ghgemmer/Halloween/TerminalLabels.docx

Arm Pitch 6V | Arm Pitch Gnd | Arm Pitch Ctrl | Arm Roll 6V | Arm Roll Gnd | Arm Roll Ctrl

Arm Yaw 6V | Arm Yaw Gnd | Arm Yaw Ctrl | Elbow Pitch 6V | Elbow Pitch Gnd | Elbow Pitch Ctrl

Mouth Ctrl | Mouth 6V | Mouth Gnd | 5V | Gnd
