ghgemmer/Halloween/IHome speaker used in vampire prop uses regular USB 2.docx

IHome speaker used in vampire prop uses regular USB 2.0 connection for charging (from computer or whatever). Manal for IHome speaker is in the “Furniture” folder
