ghgemmer/Halloween/AU5120.pdf

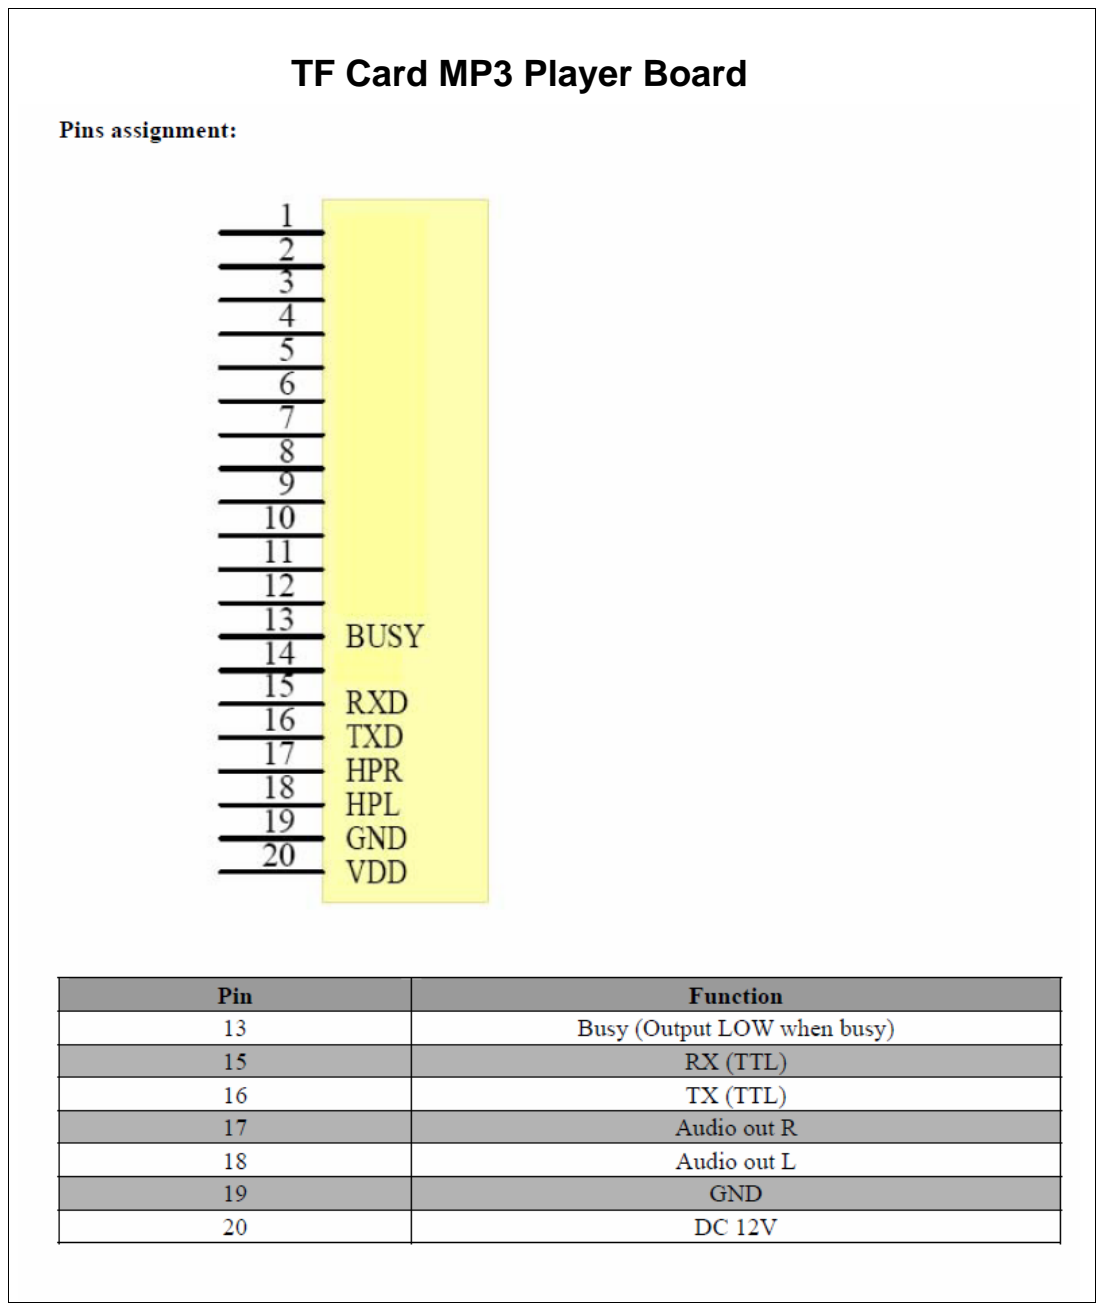
[picture p23: page 1]

TF Card MP3 Player Board

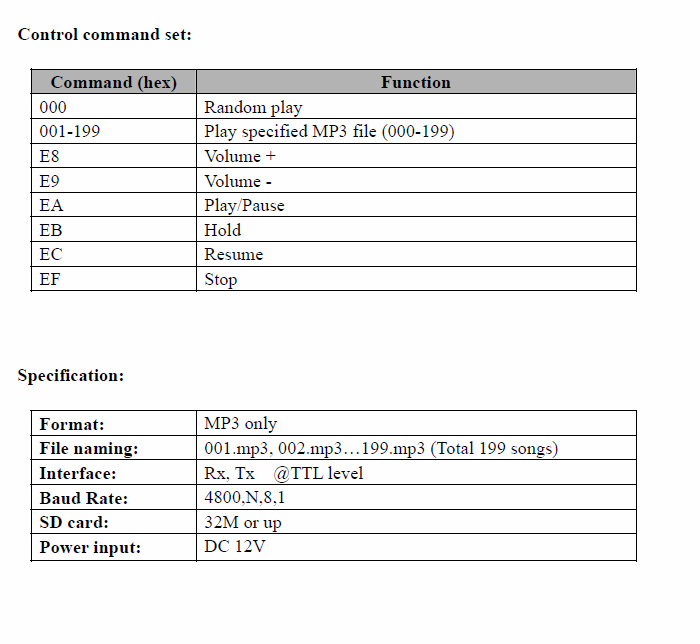
[picture p24: figure]

www.mdfly.com
