ghgemmer/Halloween/AlbumArt_{B5020207-474E-4720-407C-4E2F51993500}_Large.jpg

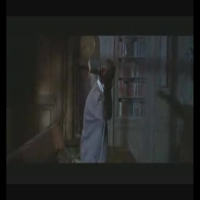
AlbumArt_{B5020207-474E-4720-407C-4E2F51993500}_Large.jpg
