ghgemmer/Halloween/Folder.jpg

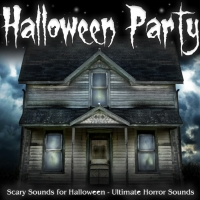
Folder.jpg
