ghgemmer/Halloween/PropPics/20211105_211012.jpg

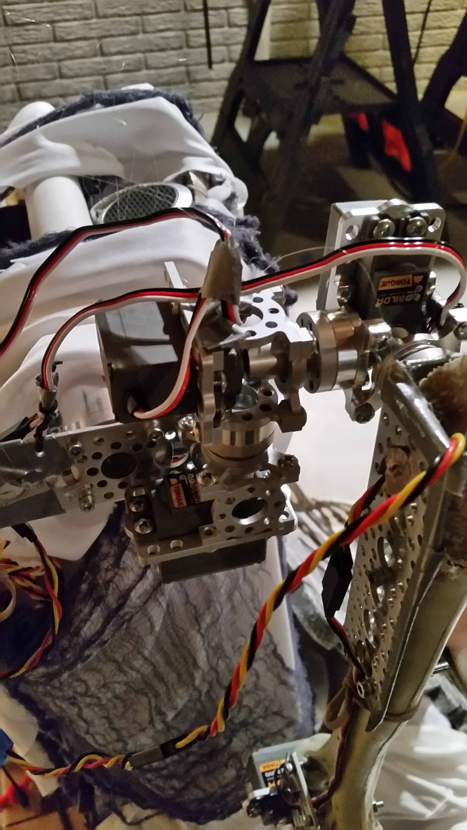
PropPics/20211105_211012.jpg
