ghgemmer/Halloween/PropPics/20211105_211126.jpg

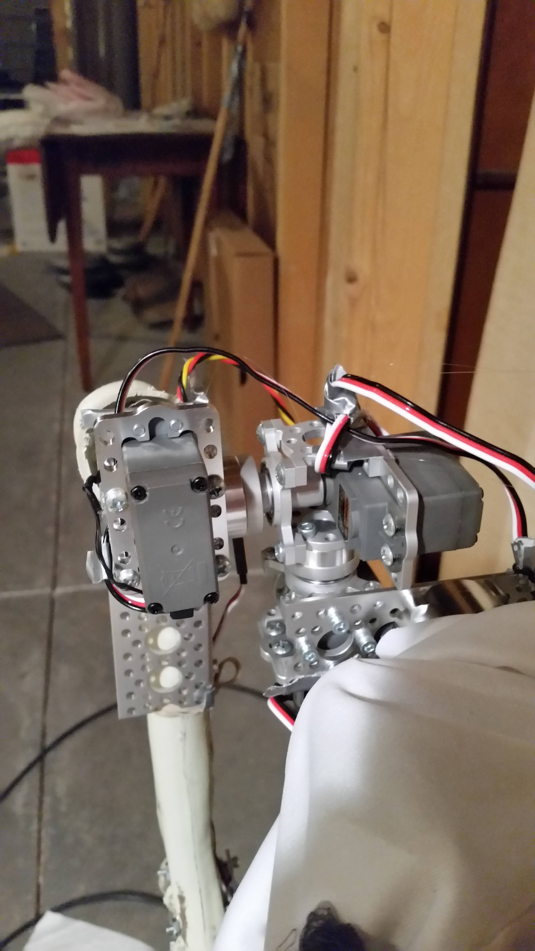
PropPics/20211105_211126.jpg
