ghgemmer/Halloween/PropPics/20211109_203104.jpg

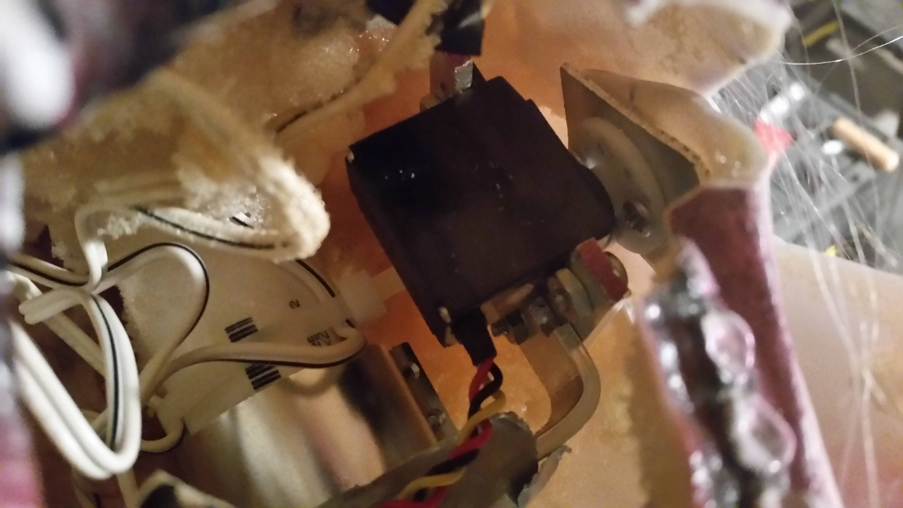
PropPics/20211109_203104.jpg
