ghgemmer/Halloween/PropPics/20211110_141706.jpg

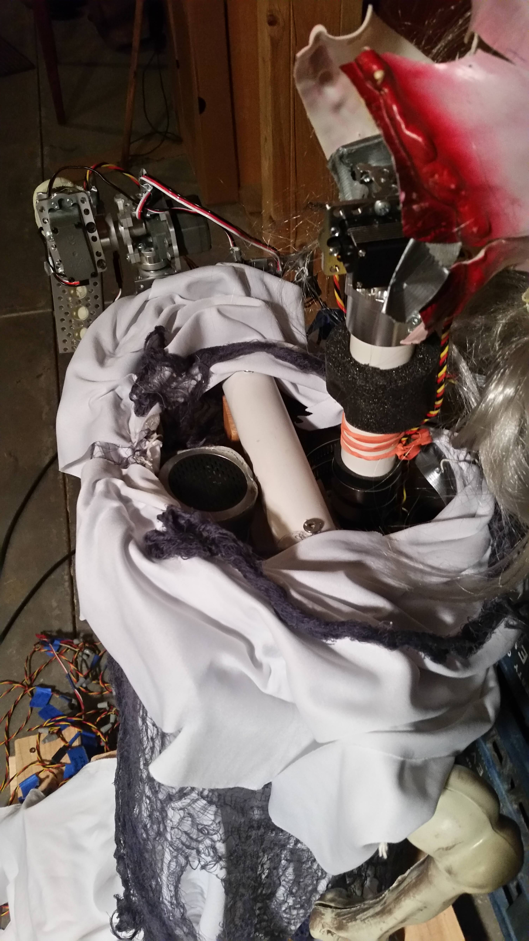
PropPics/20211110_141706.jpg
