ghgemmer/Halloween/PropPics/20240823_203854.jpg

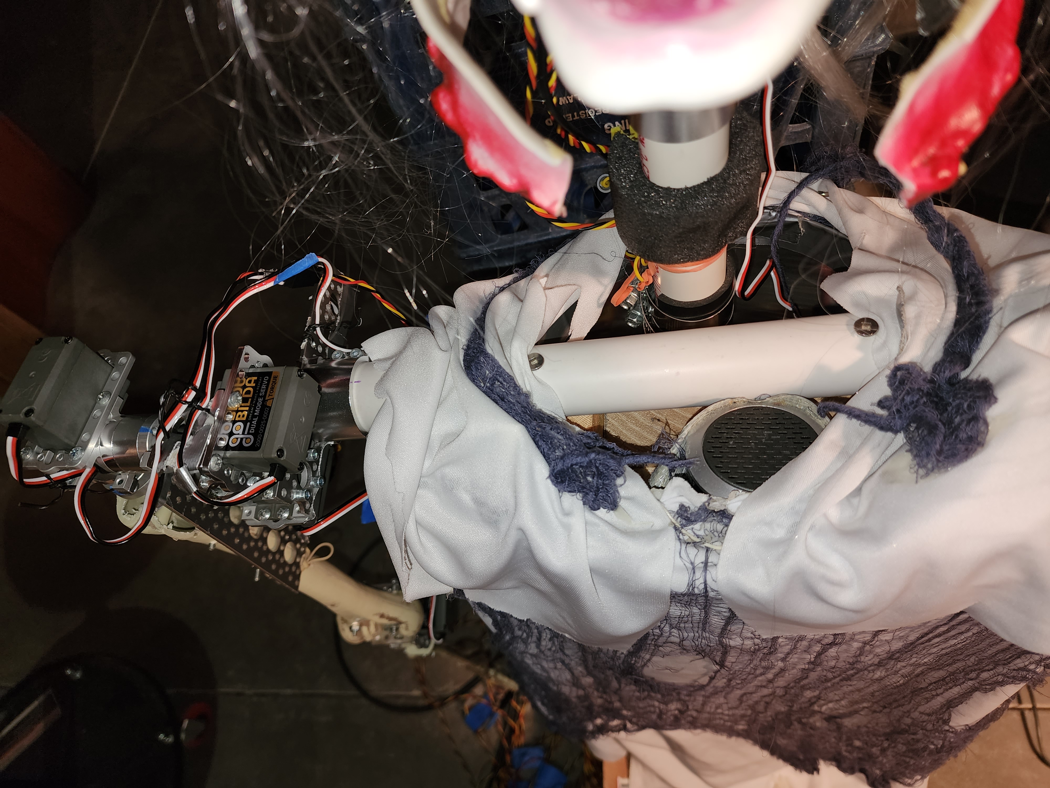
PropPics/20240823_203854.jpg
