ghgemmer/Halloween/PWMServo/SavedImplementations/Impl2/TestServos/DebugLog1.txt

(this log was before also logged servoIndex in PWMServoNew::write)

Enter PWMServoNew::attachint pinArg: 0 min: 800 max: 2200
attach Before - Reg Contents
Timer:1
TCCR1A:Adrs: 80 Val:1

TCCR1B:Adrs: 81 Val:3

OCR1A:Adrs: 88 Val:0

OCR1B:Adrs: 8A Val:0

OCR1C:Adrs: 8C Val:0

TIMSK1:Adrs: 6F Val:0

ICR1:Adrs: 86 Val:0

Timer:3
TCCR3A:Adrs: 90 Val:1

TCCR3B:Adrs: 91 Val:3

OCR3A:Adrs: 98 Val:0

OCR3B:Adrs: 9A Val:0

OCR3C:Adrs: 9C Val:0

TIMSK3:Adrs: 71 Val:0

ICR3:Adrs: 96 Val:0

Timer:4
TCCR4A:Adrs: A0 Val:1

TCCR4B:Adrs: A1 Val:3

OCR4A:Adrs: A8 Val:0

OCR4B:Adrs: AA Val:0

OCR4C:Adrs: AC Val:0

TIMSK4:Adrs: 72 Val:0

ICR4:Adrs: A6 Val:0

Timer:5
TCCR5A:Adrs: 120 Val:1

TCCR5B:Adrs: 121 Val:3

OCR5A:Adrs: 128 Val:0

OCR5B:Adrs: 12A Val:0

OCR5C:Adrs: 12C Val:0

TIMSK5:Adrs: 73 Val:0

ICR5:Adrs: 126 Val:0

HdwrCntrlInfo:
sizeof volatile unit16_t * :2
servoPinIndex: 0
boardPinNumber: 11
tccrnA: 80
tccrnB: 81
ocrnA: 88
ocrnB: 8A
timskn: 6F
icrn: 86
attachTccrnaClrMsk: 40
attachTccrnaSetMsk: 80
seizeTimerTimsknClrMsk: F
seizeTimerTimsknSetMsk: 0
detachTccrnaClrMsk: C0
detachTccrnaSetMsk: 0
writeOcrnx: 88
Enter PWMServoNew::seizeTimer
Reg Contents Before
Timer:1
TCCR1A:Adrs: 80 Val:1

TCCR1B:Adrs: 81 Val:3

OCR1A:Adrs: 88 Val:0

OCR1B:Adrs: 8A Val:0

OCR1C:Adrs: 8C Val:0

TIMSK1:Adrs: 6F Val:0

ICR1:Adrs: 86 Val:0

Timer:3
TCCR3A:Adrs: 90 Val:1

TCCR3B:Adrs: 91 Val:3

OCR3A:Adrs: 98 Val:0

OCR3B:Adrs: 9A Val:0

OCR3C:Adrs: 9C Val:0

TIMSK3:Adrs: 71 Val:0

ICR3:Adrs: 96 Val:0

Timer:4
TCCR4A:Adrs: A0 Val:1

TCCR4B:Adrs: A1 Val:3

OCR4A:Adrs: A8 Val:0

OCR4B:Adrs: AA Val:0

OCR4C:Adrs: AC Val:0

TIMSK4:Adrs: 72 Val:0

ICR4:Adrs: A6 Val:0

Timer:5
TCCR5A:Adrs: 120 Val:1

TCCR5B:Adrs: 121 Val:3

OCR5A:Adrs: 128 Val:0

OCR5B:Adrs: 12A Val:0

OCR5C:Adrs: 12C Val:0

TIMSK5:Adrs: 73 Val:0

ICR5:Adrs: 126 Val:0

Reg Contents After
Timer:1
TCCR1A:Adrs: 80 Val:2

TCCR1B:Adrs: 81 Val:1A

OCR1A:Adrs: 88 Val:BB8

OCR1B:Adrs: 8A Val:BB8

OCR1C:Adrs: 8C Val:0

TIMSK1:Adrs: 6F Val:0

ICR1:Adrs: 86 Val:9C40

Timer:3
TCCR3A:Adrs: 90 Val:1

TCCR3B:Adrs: 91 Val:3

OCR3A:Adrs: 98 Val:0

OCR3B:Adrs: 9A Val:0

OCR3C:Adrs: 9C Val:0

TIMSK3:Adrs: 71 Val:0

ICR3:Adrs: 96 Val:0

Timer:4
TCCR4A:Adrs: A0 Val:1

TCCR4B:Adrs: A1 Val:3

OCR4A:Adrs: A8 Val:0

OCR4B:Adrs: AA Val:0

OCR4C:Adrs: AC Val:0

TIMSK4:Adrs: 72 Val:0

ICR4:Adrs: A6 Val:0

Timer:5
TCCR5A:Adrs: 120 Val:1

TCCR5B:Adrs: 121 Val:3

OCR5A:Adrs: 128 Val:0

OCR5B:Adrs: 12A Val:0

OCR5C:Adrs: 12C Val:0

TIMSK5:Adrs: 73 Val:0

ICR5:Adrs: 126 Val:0

Exit PWMServoNew::seizeTimer
attach After - Reg Contents
Timer:1
TCCR1A:Adrs: 80 Val:82

TCCR1B:Adrs: 81 Val:1A

OCR1A:Adrs: 88 Val:BB8

OCR1B:Adrs: 8A Val:BB8

OCR1C:Adrs: 8C Val:0

TIMSK1:Adrs: 6F Val:0

ICR1:Adrs: 86 Val:9C40

Timer:3
TCCR3A:Adrs: 90 Val:1

TCCR3B:Adrs: 91 Val:3

OCR3A:Adrs: 98 Val:0

OCR3B:Adrs: 9A Val:0

OCR3C:Adrs: 9C Val:0

TIMSK3:Adrs: 71 Val:0

ICR3:Adrs: 96 Val:0

Timer:4
TCCR4A:Adrs: A0 Val:1

TCCR4B:Adrs: A1 Val:3

OCR4A:Adrs: A8 Val:0

OCR4B:Adrs: AA Val:0

OCR4C:Adrs: AC Val:0

TIMSK4:Adrs: 72 Val:0

ICR4:Adrs: A6 Val:0

Timer:5
TCCR5A:Adrs: 120 Val:1

TCCR5B:Adrs: 121 Val:3

OCR5A:Adrs: 128 Val:0

OCR5B:Adrs: 12A Val:0

OCR5C:Adrs: 12C Val:0

TIMSK5:Adrs: 73 Val:0

ICR5:Adrs: 126 Val:0

Servo Index:0 Attached:1
Servo Index:1 Attached:0
Servo Index:2 Attached:0
Servo Index:3 Attached:0
Servo Index:4 Attached:0
Servo Index:5 Attached:0
Servo Index:6 Attached:0
Servo Index:7 Attached:0
Servo Index:8 Attached:0
Servo Index:9 Attached:0
Servo Index:10 Attached:0
Servo Index:11 Attached:0
Exit PWMServoNew::attach
Enter PWMServoNew::attachint pinArg: 1 min: 800 max: 2200
attach Before - Reg Contents
Timer:1
TCCR1A:Adrs: 80 Val:82

TCCR1B:Adrs: 81 Val:1A

OCR1A:Adrs: 88 Val:BB8

OCR1B:Adrs: 8A Val:BB8

OCR1C:Adrs: 8C Val:0

TIMSK1:Adrs: 6F Val:0

ICR1:Adrs: 86 Val:9C40

Timer:3
TCCR3A:Adrs: 90 Val:1

TCCR3B:Adrs: 91 Val:3

OCR3A:Adrs: 98 Val:0

OCR3B:Adrs: 9A Val:0

OCR3C:Adrs: 9C Val:0

TIMSK3:Adrs: 71 Val:0

ICR3:Adrs: 96 Val:0

Timer:4
TCCR4A:Adrs: A0 Val:1

TCCR4B:Adrs: A1 Val:3

OCR4A:Adrs: A8 Val:0

OCR4B:Adrs: AA Val:0

OCR4C:Adrs: AC Val:0

TIMSK4:Adrs: 72 Val:0

ICR4:Adrs: A6 Val:0

Timer:5
TCCR5A:Adrs: 120 Val:1

TCCR5B:Adrs: 121 Val:3

OCR5A:Adrs: 128 Val:0

OCR5B:Adrs: 12A Val:0

OCR5C:Adrs: 12C Val:0

TIMSK5:Adrs: 73 Val:0

ICR5:Adrs: 126 Val:0

HdwrCntrlInfo:
sizeof volatile unit16_t * :2
servoPinIndex: 1
boardPinNumber: 12
tccrnA: 80
tccrnB: 81
ocrnA: 88
ocrnB: 8A
timskn: 6F
icrn: 86
attachTccrnaClrMsk: 10
attachTccrnaSetMsk: 20
seizeTimerTimsknClrMsk: F
seizeTimerTimsknSetMsk: 0
detachTccrnaClrMsk: 30
detachTccrnaSetMsk: 0
writeOcrnx: 8A
attach After - Reg Contents
Timer:1
TCCR1A:Adrs: 80 Val:A2

TCCR1B:Adrs: 81 Val:1A

OCR1A:Adrs: 88 Val:BB8

OCR1B:Adrs: 8A Val:BB8

OCR1C:Adrs: 8C Val:0

TIMSK1:Adrs: 6F Val:0

ICR1:Adrs: 86 Val:9C40

Timer:3
TCCR3A:Adrs: 90 Val:1

TCCR3B:Adrs: 91 Val:3

OCR3A:Adrs: 98 Val:0

OCR3B:Adrs: 9A Val:0

OCR3C:Adrs: 9C Val:0

TIMSK3:Adrs: 71 Val:0

ICR3:Adrs: 96 Val:0

Timer:4
TCCR4A:Adrs: A0 Val:1

TCCR4B:Adrs: A1 Val:3

OCR4A:Adrs: A8 Val:0

OCR4B:Adrs: AA Val:0

OCR4C:Adrs: AC Val:0

TIMSK4:Adrs: 72 Val:0

ICR4:Adrs: A6 Val:0

Timer:5
TCCR5A:Adrs: 120 Val:1

TCCR5B:Adrs: 121 Val:3

OCR5A:Adrs: 128 Val:0

OCR5B:Adrs: 12A Val:0

OCR5C:Adrs: 12C Val:0

TIMSK5:Adrs: 73 Val:0

ICR5:Adrs: 126 Val:0

Servo Index:0 Attached:1
Servo Index:1 Attached:1
Servo Index:2 Attached:0
Servo Index:3 Attached:0
Servo Index:4 Attached:0
Servo Index:5 Attached:0
Servo Index:6 Attached:0
Servo Index:7 Attached:0
Servo Index:8 Attached:0
Servo Index:9 Attached:0
Servo Index:10 Attached:0
Servo Index:11 Attached:0
Exit PWMServoNew::attach
Enter PWMServoNew::attachint pinArg: 2 min: 800 max: 2200
attach Before - Reg Contents
Timer:1
TCCR1A:Adrs: 80 Val:A2

TCCR1B:Adrs: 81 Val:1A

OCR1A:Adrs: 88 Val:BB8

OCR1B:Adrs: 8A Val:BB8

OCR1C:Adrs: 8C Val:0

TIMSK1:Adrs: 6F Val:0

ICR1:Adrs: 86 Val:9C40

Timer:3
TCCR3A:Adrs: 90 Val:1

TCCR3B:Adrs: 91 Val:3

OCR3A:Adrs: 98 Val:0

OCR3B:Adrs: 9A Val:0

OCR3C:Adrs: 9C Val:0

TIMSK3:Adrs: 71 Val:0

ICR3:Adrs: 96 Val:0

Timer:4
TCCR4A:Adrs: A0 Val:1

TCCR4B:Adrs: A1 Val:3

OCR4A:Adrs: A8 Val:0

OCR4B:Adrs: AA Val:0

OCR4C:Adrs: AC Val:0

TIMSK4:Adrs: 72 Val:0

ICR4:Adrs: A6 Val:0

Timer:5
TCCR5A:Adrs: 120 Val:1

TCCR5B:Adrs: 121 Val:3

OCR5A:Adrs: 128 Val:0

OCR5B:Adrs: 12A Val:0

OCR5C:Adrs: 12C Val:0

TIMSK5:Adrs: 73 Val:0

ICR5:Adrs: 126 Val:0

HdwrCntrlInfo:
sizeof volatile unit16_t * :2
servoPinIndex: 2
boardPinNumber: 13
tccrnA: 80
tccrnB: 81
ocrnA: 88
ocrnB: 8A
timskn: 6F
icrn: 86
attachTccrnaClrMsk: 4
attachTccrnaSetMsk: 8
seizeTimerTimsknClrMsk: F
seizeTimerTimsknSetMsk: 0
detachTccrnaClrMsk: C
detachTccrnaSetMsk: 0
writeOcrnx: 8C
attach After - Reg Contents
Timer:1
TCCR1A:Adrs: 80 Val:AA

TCCR1B:Adrs: 81 Val:1A

OCR1A:Adrs: 88 Val:BB8

OCR1B:Adrs: 8A Val:BB8

OCR1C:Adrs: 8C Val:0

TIMSK1:Adrs: 6F Val:0

ICR1:Adrs: 86 Val:9C40

Timer:3
TCCR3A:Adrs: 90 Val:1

TCCR3B:Adrs: 91 Val:3

OCR3A:Adrs: 98 Val:0

OCR3B:Adrs: 9A Val:0

OCR3C:Adrs: 9C Val:0

TIMSK3:Adrs: 71 Val:0

ICR3:Adrs: 96 Val:0

Timer:4
TCCR4A:Adrs: A0 Val:1

TCCR4B:Adrs: A1 Val:3

OCR4A:Adrs: A8 Val:0

OCR4B:Adrs: AA Val:0

OCR4C:Adrs: AC Val:0

TIMSK4:Adrs: 72 Val:0

ICR4:Adrs: A6 Val:0

Timer:5
TCCR5A:Adrs: 120 Val:1

TCCR5B:Adrs: 121 Val:3

OCR5A:Adrs: 128 Val:0

OCR5B:Adrs: 12A Val:0

OCR5C:Adrs: 12C Val:0

TIMSK5:Adrs: 73 Val:0

ICR5:Adrs: 126 Val:0

Servo Index:0 Attached:1
Servo Index:1 Attached:1
Servo Index:2 Attached:1
Servo Index:3 Attached:0
Servo Index:4 Attached:0
Servo Index:5 Attached:0
Servo Index:6 Attached:0
Servo Index:7 Attached:0
Servo Index:8 Attached:0
Servo Index:9 Attached:0
Servo Index:10 Attached:0
Servo Index:11 Attached:0
Exit PWMServoNew::attach
Enter PWMServoNew::attachint pinArg: 3 min: 800 max: 2200
attach Before - Reg Contents
Timer:1
TCCR1A:Adrs: 80 Val:AA

TCCR1B:Adrs: 81 Val:1A

OCR1A:Adrs: 88 Val:BB8

OCR1B:Adrs: 8A Val:BB8

OCR1C:Adrs: 8C Val:0

TIMSK1:Adrs: 6F Val:0

ICR1:Adrs: 86 Val:9C40

Timer:3
TCCR3A:Adrs: 90 Val:1

TCCR3B:Adrs: 91 Val:3

OCR3A:Adrs: 98 Val:0

OCR3B:Adrs: 9A Val:0

OCR3C:Adrs: 9C Val:0

TIMSK3:Adrs: 71 Val:0

ICR3:Adrs: 96 Val:0

Timer:4
TCCR4A:Adrs: A0 Val:1

TCCR4B:Adrs: A1 Val:3

OCR4A:Adrs: A8 Val:0

OCR4B:Adrs: AA Val:0

OCR4C:Adrs: AC Val:0

TIMSK4:Adrs: 72 Val:0

ICR4:Adrs: A6 Val:0

Timer:5
TCCR5A:Adrs: 120 Val:1

TCCR5B:Adrs: 121 Val:3

OCR5A:Adrs: 128 Val:0

OCR5B:Adrs: 12A Val:0

OCR5C:Adrs: 12C Val:0

TIMSK5:Adrs: 73 Val:0

ICR5:Adrs: 126 Val:0

HdwrCntrlInfo:
sizeof volatile unit16_t * :2
servoPinIndex: 3
boardPinNumber: 5
tccrnA: 90
tccrnB: 91
ocrnA: 98
ocrnB: 9A
timskn: 71
icrn: 96
attachTccrnaClrMsk: 40
attachTccrnaSetMsk: 80
seizeTimerTimsknClrMsk: F
seizeTimerTimsknSetMsk: 0
detachTccrnaClrMsk: C0
detachTccrnaSetMsk: 0
writeOcrnx: 98
Enter PWMServoNew::seizeTimer
Reg Contents Before
Timer:1
TCCR1A:Adrs: 80 Val:AA

TCCR1B:Adrs: 81 Val:1A

OCR1A:Adrs: 88 Val:BB8

OCR1B:Adrs: 8A Val:BB8

OCR1C:Adrs: 8C Val:0

TIMSK1:Adrs: 6F Val:0

ICR1:Adrs: 86 Val:9C40

Timer:3
TCCR3A:Adrs: 90 Val:1

TCCR3B:Adrs: 91 Val:3

OCR3A:Adrs: 98 Val:0

OCR3B:Adrs: 9A Val:0

OCR3C:Adrs: 9C Val:0

TIMSK3:Adrs: 71 Val:0

ICR3:Adrs: 96 Val:0

Timer:4
TCCR4A:Adrs: A0 Val:1

TCCR4B:Adrs: A1 Val:3

OCR4A:Adrs: A8 Val:0

OCR4B:Adrs: AA Val:0

OCR4C:Adrs: AC Val:0

TIMSK4:Adrs: 72 Val:0

ICR4:Adrs: A6 Val:0

Timer:5
TCCR5A:Adrs: 120 Val:1

TCCR5B:Adrs: 121 Val:3

OCR5A:Adrs: 128 Val:0

OCR5B:Adrs: 12A Val:0

OCR5C:Adrs: 12C Val:0

TIMSK5:Adrs: 73 Val:0

ICR5:Adrs: 126 Val:0

Reg Contents After
Timer:1
TCCR1A:Adrs: 80 Val:AA

TCCR1B:Adrs: 81 Val:1A

OCR1A:Adrs: 88 Val:BB8

OCR1B:Adrs: 8A Val:BB8

OCR1C:Adrs: 8C Val:0

TIMSK1:Adrs: 6F Val:0

ICR1:Adrs: 86 Val:9C40

Timer:3
TCCR3A:Adrs: 90 Val:2

TCCR3B:Adrs: 91 Val:1A

OCR3A:Adrs: 98 Val:BB8

OCR3B:Adrs: 9A Val:BB8

OCR3C:Adrs: 9C Val:0

TIMSK3:Adrs: 71 Val:0

ICR3:Adrs: 96 Val:9C40

Timer:4
TCCR4A:Adrs: A0 Val:1

TCCR4B:Adrs: A1 Val:3

OCR4A:Adrs: A8 Val:0

OCR4B:Adrs: AA Val:0

OCR4C:Adrs: AC Val:0

TIMSK4:Adrs: 72 Val:0

ICR4:Adrs: A6 Val:0

Timer:5
TCCR5A:Adrs: 120 Val:1

TCCR5B:Adrs: 121 Val:3

OCR5A:Adrs: 128 Val:0

OCR5B:Adrs: 12A Val:0

OCR5C:Adrs: 12C Val:0

TIMSK5:Adrs: 73 Val:0

ICR5:Adrs: 126 Val:0

Exit PWMServoNew::seizeTimer
attach After - Reg Contents
Timer:1
TCCR1A:Adrs: 80 Val:AA

TCCR1B:Adrs: 81 Val:1A

OCR1A:Adrs: 88 Val:BB8

OCR1B:Adrs: 8A Val:BB8

OCR1C:Adrs: 8C Val:0

TIMSK1:Adrs: 6F Val:0

ICR1:Adrs: 86 Val:9C40

Timer:3
TCCR3A:Adrs: 90 Val:82

TCCR3B:Adrs: 91 Val:1A

OCR3A:Adrs: 98 Val:BB8

OCR3B:Adrs: 9A Val:BB8

OCR3C:Adrs: 9C Val:0

TIMSK3:Adrs: 71 Val:0

ICR3:Adrs: 96 Val:9C40

Timer:4
TCCR4A:Adrs: A0 Val:1

TCCR4B:Adrs: A1 Val:3

OCR4A:Adrs: A8 Val:0

OCR4B:Adrs: AA Val:0

OCR4C:Adrs: AC Val:0

TIMSK4:Adrs: 72 Val:0

ICR4:Adrs: A6 Val:0

Timer:5
TCCR5A:Adrs: 120 Val:1

TCCR5B:Adrs: 121 Val:3

OCR5A:Adrs: 128 Val:0

OCR5B:Adrs: 12A Val:0

OCR5C:Adrs: 12C Val:0

TIMSK5:Adrs: 73 Val:0

ICR5:Adrs: 126 Val:0

Servo Index:0 Attached:1
Servo Index:1 Attached:1
Servo Index:2 Attached:1
Servo Index:3 Attached:1
Servo Index:4 Attached:0
Servo Index:5 Attached:0
Servo Index:6 Attached:0
Servo Index:7 Attached:0
Servo Index:8 Attached:0
Servo Index:9 Attached:0
Servo Index:10 Attached:0
Servo Index:11 Attached:0
Exit PWMServoNew::attach
Enter PWMServoNew::attachint pinArg: 4 min: 800 max: 2200
attach Before - Reg Contents
Timer:1
TCCR1A:Adrs: 80 Val:AA

TCCR1B:Adrs: 81 Val:1A

OCR1A:Adrs: 88 Val:BB8

OCR1B:Adrs: 8A Val:BB8

OCR1C:Adrs: 8C Val:0

TIMSK1:Adrs: 6F Val:0

ICR1:Adrs: 86 Val:9C40

Timer:3
TCCR3A:Adrs: 90 Val:82

TCCR3B:Adrs: 91 Val:1A

OCR3A:Adrs: 98 Val:BB8

OCR3B:Adrs: 9A Val:BB8

OCR3C:Adrs: 9C Val:0

TIMSK3:Adrs: 71 Val:0

ICR3:Adrs: 96 Val:9C40

Timer:4
TCCR4A:Adrs: A0 Val:1

TCCR4B:Adrs: A1 Val:3

OCR4A:Adrs: A8 Val:0

OCR4B:Adrs: AA Val:0

OCR4C:Adrs: AC Val:0

TIMSK4:Adrs: 72 Val:0

ICR4:Adrs: A6 Val:0

Timer:5
TCCR5A:Adrs: 120 Val:1

TCCR5B:Adrs: 121 Val:3

OCR5A:Adrs: 128 Val:0

OCR5B:Adrs: 12A Val:0

OCR5C:Adrs: 12C Val:0

TIMSK5:Adrs: 73 Val:0

ICR5:Adrs: 126 Val:0

HdwrCntrlInfo:
sizeof volatile unit16_t * :2
servoPinIndex: 4
boardPinNumber: 2
tccrnA: 90
tccrnB: 91
ocrnA: 98
ocrnB: 9A
timskn: 71
icrn: 96
attachTccrnaClrMsk: 10
attachTccrnaSetMsk: 20
seizeTimerTimsknClrMsk: F
seizeTimerTimsknSetMsk: 0
detachTccrnaClrMsk: 30
detachTccrnaSetMsk: 0
writeOcrnx: 9A
attach After - Reg Contents
Timer:1
TCCR1A:Adrs: 80 Val:AA

TCCR1B:Adrs: 81 Val:1A

OCR1A:Adrs: 88 Val:BB8

OCR1B:Adrs: 8A Val:BB8

OCR1C:Adrs: 8C Val:0

TIMSK1:Adrs: 6F Val:0

ICR1:Adrs: 86 Val:9C40

Timer:3
TCCR3A:Adrs: 90 Val:A2

TCCR3B:Adrs: 91 Val:1A

OCR3A:Adrs: 98 Val:BB8

OCR3B:Adrs: 9A Val:BB8

OCR3C:Adrs: 9C Val:0

TIMSK3:Adrs: 71 Val:0

ICR3:Adrs: 96 Val:9C40

Timer:4
TCCR4A:Adrs: A0 Val:1

TCCR4B:Adrs: A1 Val:3

OCR4A:Adrs: A8 Val:0

OCR4B:Adrs: AA Val:0

OCR4C:Adrs: AC Val:0

TIMSK4:Adrs: 72 Val:0

ICR4:Adrs: A6 Val:0

Timer:5
TCCR5A:Adrs: 120 Val:1

TCCR5B:Adrs: 121 Val:3

OCR5A:Adrs: 128 Val:0

OCR5B:Adrs: 12A Val:0

OCR5C:Adrs: 12C Val:0

TIMSK5:Adrs: 73 Val:0

ICR5:Adrs: 126 Val:0

Servo Index:0 Attached:1
Servo Index:1 Attached:1
Servo Index:2 Attached:1
Servo Index:3 Attached:1
Servo Index:4 Attached:1
Servo Index:5 Attached:0
Servo Index:6 Attached:0
Servo Index:7 Attached:0
Servo Index:8 Attached:0
Servo Index:9 Attached:0
Servo Index:10 Attached:0
Servo Index:11 Attached:0
Exit PWMServoNew::attach
Enter PWMServoNew::attachint pinArg: 5 min: 800 max: 2200
attach Before - Reg Contents
Timer:1
TCCR1A:Adrs: 80 Val:AA

TCCR1B:Adrs: 81 Val:1A

OCR1A:Adrs: 88 Val:BB8

OCR1B:Adrs: 8A Val:BB8

OCR1C:Adrs: 8C Val:0

TIMSK1:Adrs: 6F Val:0

ICR1:Adrs: 86 Val:9C40

Timer:3
TCCR3A:Adrs: 90 Val:A2

TCCR3B:Adrs: 91 Val:1A

OCR3A:Adrs: 98 Val:BB8

OCR3B:Adrs: 9A Val:BB8

OCR3C:Adrs: 9C Val:0

TIMSK3:Adrs: 71 Val:0

ICR3:Adrs: 96 Val:9C40

Timer:4
TCCR4A:Adrs: A0 Val:1

TCCR4B:Adrs: A1 Val:3

OCR4A:Adrs: A8 Val:0

OCR4B:Adrs: AA Val:0

OCR4C:Adrs: AC Val:0

TIMSK4:Adrs: 72 Val:0

ICR4:Adrs: A6 Val:0

Timer:5
TCCR5A:Adrs: 120 Val:1

TCCR5B:Adrs: 121 Val:3

OCR5A:Adrs: 128 Val:0

OCR5B:Adrs: 12A Val:0

OCR5C:Adrs: 12C Val:0

TIMSK5:Adrs: 73 Val:0

ICR5:Adrs: 126 Val:0

HdwrCntrlInfo:
sizeof volatile unit16_t * :2
servoPinIndex: 5
boardPinNumber: 3
tccrnA: 90
tccrnB: 91
ocrnA: 98
ocrnB: 9A
timskn: 71
icrn: 96
attachTccrnaClrMsk: 4
attachTccrnaSetMsk: 8
seizeTimerTimsknClrMsk: F
seizeTimerTimsknSetMsk: 0
detachTccrnaClrMsk: C
detachTccrnaSetMsk: 0
writeOcrnx: 9C
attach After - Reg Contents
Timer:1
TCCR1A:Adrs: 80 Val:AA

TCCR1B:Adrs: 81 Val:1A

OCR1A:Adrs: 88 Val:BB8

OCR1B:Adrs: 8A Val:BB8

OCR1C:Adrs: 8C Val:0

TIMSK1:Adrs: 6F Val:0

ICR1:Adrs: 86 Val:9C40

Timer:3
TCCR3A:Adrs: 90 Val:AA

TCCR3B:Adrs: 91 Val:1A

OCR3A:Adrs: 98 Val:BB8

OCR3B:Adrs: 9A Val:BB8

OCR3C:Adrs: 9C Val:0

TIMSK3:Adrs: 71 Val:0

ICR3:Adrs: 96 Val:9C40

Timer:4
TCCR4A:Adrs: A0 Val:1

TCCR4B:Adrs: A1 Val:3

OCR4A:Adrs: A8 Val:0

OCR4B:Adrs: AA Val:0

OCR4C:Adrs: AC Val:0

TIMSK4:Adrs: 72 Val:0

ICR4:Adrs: A6 Val:0

Timer:5
TCCR5A:Adrs: 120 Val:1

TCCR5B:Adrs: 121 Val:3

OCR5A:Adrs: 128 Val:0

OCR5B:Adrs: 12A Val:0

OCR5C:Adrs: 12C Val:0

TIMSK5:Adrs: 73 Val:0

ICR5:Adrs: 126 Val:0

Servo Index:0 Attached:1
Servo Index:1 Attached:1
Servo Index:2 Attached:1
Servo Index:3 Attached:1
Servo Index:4 Attached:1
Servo Index:5 Attached:1
Servo Index:6 Attached:0
Servo Index:7 Attached:0
Servo Index:8 Attached:0
Servo Index:9 Attached:0
Servo Index:10 Attached:0
Servo Index:11 Attached:0
Exit PWMServoNew::attach
Enter PWMServoNew::attachint pinArg: 6 min: 800 max: 2200
attach Before - Reg Contents
Timer:1
TCCR1A:Adrs: 80 Val:AA

TCCR1B:Adrs: 81 Val:1A

OCR1A:Adrs: 88 Val:BB8

OCR1B:Adrs: 8A Val:BB8

OCR1C:Adrs: 8C Val:0

TIMSK1:Adrs: 6F Val:0

ICR1:Adrs: 86 Val:9C40

Timer:3
TCCR3A:Adrs: 90 Val:AA

TCCR3B:Adrs: 91 Val:1A

OCR3A:Adrs: 98 Val:BB8

OCR3B:Adrs: 9A Val:BB8

OCR3C:Adrs: 9C Val:0

TIMSK3:Adrs: 71 Val:0

ICR3:Adrs: 96 Val:9C40

Timer:4
TCCR4A:Adrs: A0 Val:1

TCCR4B:Adrs: A1 Val:3

OCR4A:Adrs: A8 Val:0

OCR4B:Adrs: AA Val:0

OCR4C:Adrs: AC Val:0

TIMSK4:Adrs: 72 Val:0

ICR4:Adrs: A6 Val:0

Timer:5
TCCR5A:Adrs: 120 Val:1

TCCR5B:Adrs: 121 Val:3

OCR5A:Adrs: 128 Val:0

OCR5B:Adrs: 12A Val:0

OCR5C:Adrs: 12C Val:0

TIMSK5:Adrs: 73 Val:0

ICR5:Adrs: 126 Val:0

HdwrCntrlInfo:
sizeof volatile unit16_t * :2
servoPinIndex: 6
boardPinNumber: 6
tccrnA: A0
tccrnB: A1
ocrnA: A8
ocrnB: AA
timskn: 72
icrn: A6
attachTccrnaClrMsk: 40
attachTccrnaSetMsk: 80
seizeTimerTimsknClrMsk: F
seizeTimerTimsknSetMsk: 0
detachTccrnaClrMsk: C0
detachTccrnaSetMsk: 0
writeOcrnx: A8
Enter PWMServoNew::seizeTimer
Reg Contents Before
Timer:1
TCCR1A:Adrs: 80 Val:AA

TCCR1B:Adrs: 81 Val:1A

OCR1A:Adrs: 88 Val:BB8

OCR1B:Adrs: 8A Val:BB8

OCR1C:Adrs: 8C Val:0

TIMSK1:Adrs: 6F Val:0

ICR1:Adrs: 86 Val:9C40

Timer:3
TCCR3A:Adrs: 90 Val:AA

TCCR3B:Adrs: 91 Val:1A

OCR3A:Adrs: 98 Val:BB8

OCR3B:Adrs: 9A Val:BB8

OCR3C:Adrs: 9C Val:0

TIMSK3:Adrs: 71 Val:0

ICR3:Adrs: 96 Val:9C40

Timer:4
TCCR4A:Adrs: A0 Val:1

TCCR4B:Adrs: A1 Val:3

OCR4A:Adrs: A8 Val:0

OCR4B:Adrs: AA Val:0

OCR4C:Adrs: AC Val:0

TIMSK4:Adrs: 72 Val:0

ICR4:Adrs: A6 Val:0

Timer:5
TCCR5A:Adrs: 120 Val:1

TCCR5B:Adrs: 121 Val:3

OCR5A:Adrs: 128 Val:0

OCR5B:Adrs: 12A Val:0

OCR5C:Adrs: 12C Val:0

TIMSK5:Adrs: 73 Val:0

ICR5:Adrs: 126 Val:0

Reg Contents After
Timer:1
TCCR1A:Adrs: 80 Val:AA

TCCR1B:Adrs: 81 Val:1A

OCR1A:Adrs: 88 Val:BB8

OCR1B:Adrs: 8A Val:BB8

OCR1C:Adrs: 8C Val:0

TIMSK1:Adrs: 6F Val:0

ICR1:Adrs: 86 Val:9C40

Timer:3
TCCR3A:Adrs: 90 Val:AA

TCCR3B:Adrs: 91 Val:1A

OCR3A:Adrs: 98 Val:BB8

OCR3B:Adrs: 9A Val:BB8

OCR3C:Adrs: 9C Val:0

TIMSK3:Adrs: 71 Val:0

ICR3:Adrs: 96 Val:9C40

Timer:4
TCCR4A:Adrs: A0 Val:2

TCCR4B:Adrs: A1 Val:1A

OCR4A:Adrs: A8 Val:BB8

OCR4B:Adrs: AA Val:BB8

OCR4C:Adrs: AC Val:0

TIMSK4:Adrs: 72 Val:0

ICR4:Adrs: A6 Val:9C40

Timer:5
TCCR5A:Adrs: 120 Val:1

TCCR5B:Adrs: 121 Val:3

OCR5A:Adrs: 128 Val:0

OCR5B:Adrs: 12A Val:0

OCR5C:Adrs: 12C Val:0

TIMSK5:Adrs: 73 Val:0

ICR5:Adrs: 126 Val:0

Exit PWMServoNew::seizeTimer
attach After - Reg Contents
Timer:1
TCCR1A:Adrs: 80 Val:AA

TCCR1B:Adrs: 81 Val:1A

OCR1A:Adrs: 88 Val:BB8

OCR1B:Adrs: 8A Val:BB8

OCR1C:Adrs: 8C Val:0

TIMSK1:Adrs: 6F Val:0

ICR1:Adrs: 86 Val:9C40

Timer:3
TCCR3A:Adrs: 90 Val:AA

TCCR3B:Adrs: 91 Val:1A

OCR3A:Adrs: 98 Val:BB8

OCR3B:Adrs: 9A Val:BB8

OCR3C:Adrs: 9C Val:0

TIMSK3:Adrs: 71 Val:0

ICR3:Adrs: 96 Val:9C40

Timer:4
TCCR4A:Adrs: A0 Val:82

TCCR4B:Adrs: A1 Val:1A

OCR4A:Adrs: A8 Val:BB8

OCR4B:Adrs: AA Val:BB8

OCR4C:Adrs: AC Val:0

TIMSK4:Adrs: 72 Val:0

ICR4:Adrs: A6 Val:9C40

Timer:5
TCCR5A:Adrs: 120 Val:1

TCCR5B:Adrs: 121 Val:3

OCR5A:Adrs: 128 Val:0

OCR5B:Adrs: 12A Val:0

OCR5C:Adrs: 12C Val:0

TIMSK5:Adrs: 73 Val:0

ICR5:Adrs: 126 Val:0

Servo Index:0 Attached:1
Servo Index:1 Attached:1
Servo Index:2 Attached:1
Servo Index:3 Attached:1
Servo Index:4 Attached:1
Servo Index:5 Attached:1
Servo Index:6 Attached:1
Servo Index:7 Attached:0
Servo Index:8 Attached:0
Servo Index:9 Attached:0
Servo Index:10 Attached:0
Servo Index:11 Attached:0
Exit PWMServoNew::attach
Enter PWMServoNew::attachint pinArg: 7 min: 800 max: 2200
attach Before - Reg Contents
Timer:1
TCCR1A:Adrs: 80 Val:AA

TCCR1B:Adrs: 81 Val:1A

OCR1A:Adrs: 88 Val:BB8

OCR1B:Adrs: 8A Val:BB8

OCR1C:Adrs: 8C Val:0

TIMSK1:Adrs: 6F Val:0

ICR1:Adrs: 86 Val:9C40

Timer:3
TCCR3A:Adrs: 90 Val:AA

TCCR3B:Adrs: 91 Val:1A

OCR3A:Adrs: 98 Val:BB8

OCR3B:Adrs: 9A Val:BB8

OCR3C:Adrs: 9C Val:0

TIMSK3:Adrs: 71 Val:0

ICR3:Adrs: 96 Val:9C40

Timer:4
TCCR4A:Adrs: A0 Val:82

TCCR4B:Adrs: A1 Val:1A

OCR4A:Adrs: A8 Val:BB8

OCR4B:Adrs: AA Val:BB8

OCR4C:Adrs: AC Val:0

TIMSK4:Adrs: 72 Val:0

ICR4:Adrs: A6 Val:9C40

Timer:5
TCCR5A:Adrs: 120 Val:1

TCCR5B:Adrs: 121 Val:3

OCR5A:Adrs: 128 Val:0

OCR5B:Adrs: 12A Val:0

OCR5C:Adrs: 12C Val:0

TIMSK5:Adrs: 73 Val:0

ICR5:Adrs: 126 Val:0

HdwrCntrlInfo:
sizeof volatile unit16_t * :2
servoPinIndex: 7
boardPinNumber: 7
tccrnA: A0
tccrnB: A1
ocrnA: A8
ocrnB: AA
timskn: 72
icrn: A6
attachTccrnaClrMsk: 10
attachTccrnaSetMsk: 20
seizeTimerTimsknClrMsk: F
seizeTimerTimsknSetMsk: 0
detachTccrnaClrMsk: 30
detachTccrnaSetMsk: 0
writeOcrnx: AA
attach After - Reg Contents
Timer:1
TCCR1A:Adrs: 80 Val:AA

TCCR1B:Adrs: 81 Val:1A

OCR1A:Adrs: 88 Val:BB8

OCR1B:Adrs: 8A Val:BB8

OCR1C:Adrs: 8C Val:0

TIMSK1:Adrs: 6F Val:0

ICR1:Adrs: 86 Val:9C40

Timer:3
TCCR3A:Adrs: 90 Val:AA

TCCR3B:Adrs: 91 Val:1A

OCR3A:Adrs: 98 Val:BB8

OCR3B:Adrs: 9A Val:BB8

OCR3C:Adrs: 9C Val:0

TIMSK3:Adrs: 71 Val:0

ICR3:Adrs: 96 Val:9C40

Timer:4
TCCR4A:Adrs: A0 Val:A2

TCCR4B:Adrs: A1 Val:1A

OCR4A:Adrs: A8 Val:BB8

OCR4B:Adrs: AA Val:BB8

OCR4C:Adrs: AC Val:0

TIMSK4:Adrs: 72 Val:0

ICR4:Adrs: A6 Val:9C40

Timer:5
TCCR5A:Adrs: 120 Val:1

TCCR5B:Adrs: 121 Val:3

OCR5A:Adrs: 128 Val:0

OCR5B:Adrs: 12A Val:0

OCR5C:Adrs: 12C Val:0

TIMSK5:Adrs: 73 Val:0

ICR5:Adrs: 126 Val:0

Servo Index:0 Attached:1
Servo Index:1 Attached:1
Servo Index:2 Attached:1
Servo Index:3 Attached:1
Servo Index:4 Attached:1
Servo Index:5 Attached:1
Servo Index:6 Attached:1
Servo Index:7 Attached:1
Servo Index:8 Attached:0
Servo Index:9 Attached:0
Servo Index:10 Attached:0
Servo Index:11 Attached:0
Exit PWMServoNew::attach
Enter PWMServoNew::attachint pinArg: 8 min: 800 max: 2200
attach Before - Reg Contents
Timer:1
TCCR1A:Adrs: 80 Val:AA

TCCR1B:Adrs: 81 Val:1A

OCR1A:Adrs: 88 Val:BB8

OCR1B:Adrs: 8A Val:BB8

OCR1C:Adrs: 8C Val:0

TIMSK1:Adrs: 6F Val:0

ICR1:Adrs: 86 Val:9C40

Timer:3
TCCR3A:Adrs: 90 Val:AA

TCCR3B:Adrs: 91 Val:1A

OCR3A:Adrs: 98 Val:BB8

OCR3B:Adrs: 9A Val:BB8

OCR3C:Adrs: 9C Val:0

TIMSK3:Adrs: 71 Val:0

ICR3:Adrs: 96 Val:9C40

Timer:4
TCCR4A:Adrs: A0 Val:A2

TCCR4B:Adrs: A1 Val:1A

OCR4A:Adrs: A8 Val:BB8

OCR4B:Adrs: AA Val:BB8

OCR4C:Adrs: AC Val:0

TIMSK4:Adrs: 72 Val:0

ICR4:Adrs: A6 Val:9C40

Timer:5
TCCR5A:Adrs: 120 Val:1

TCCR5B:Adrs: 121 Val:3

OCR5A:Adrs: 128 Val:0

OCR5B:Adrs: 12A Val:0

OCR5C:Adrs: 12C Val:0

TIMSK5:Adrs: 73 Val:0

ICR5:Adrs: 126 Val:0

HdwrCntrlInfo:
sizeof volatile unit16_t * :2
servoPinIndex: 8
boardPinNumber: 8
tccrnA: A0
tccrnB: A1
ocrnA: A8
ocrnB: AA
timskn: 72
icrn: A6
attachTccrnaClrMsk: 4
attachTccrnaSetMsk: 8
seizeTimerTimsknClrMsk: F
seizeTimerTimsknSetMsk: 0
detachTccrnaClrMsk: C
detachTccrnaSetMsk: 0
writeOcrnx: AC
attach After - Reg Contents
Timer:1
TCCR1A:Adrs: 80 Val:AA

TCCR1B:Adrs: 81 Val:1A

OCR1A:Adrs: 88 Val:BB8

OCR1B:Adrs: 8A Val:BB8

OCR1C:Adrs: 8C Val:0

TIMSK1:Adrs: 6F Val:0

ICR1:Adrs: 86 Val:9C40

Timer:3
TCCR3A:Adrs: 90 Val:AA

TCCR3B:Adrs: 91 Val:1A

OCR3A:Adrs: 98 Val:BB8

OCR3B:Adrs: 9A Val:BB8

OCR3C:Adrs: 9C Val:0

TIMSK3:Adrs: 71 Val:0

ICR3:Adrs: 96 Val:9C40

Timer:4
TCCR4A:Adrs: A0 Val:AA

TCCR4B:Adrs: A1 Val:1A

OCR4A:Adrs: A8 Val:BB8

OCR4B:Adrs: AA Val:BB8

OCR4C:Adrs: AC Val:0

TIMSK4:Adrs: 72 Val:0

ICR4:Adrs: A6 Val:9C40

Timer:5
TCCR5A:Adrs: 120 Val:1

TCCR5B:Adrs: 121 Val:3

OCR5A:Adrs: 128 Val:0

OCR5B:Adrs: 12A Val:0

OCR5C:Adrs: 12C Val:0

TIMSK5:Adrs: 73 Val:0

ICR5:Adrs: 126 Val:0

Servo Index:0 Attached:1
Servo Index:1 Attached:1
Servo Index:2 Attached:1
Servo Index:3 Attached:1
Servo Index:4 Attached:1
Servo Index:5 Attached:1
Servo Index:6 Attached:1
Servo Index:7 Attached:1
Servo Index:8 Attached:1
Servo Index:9 Attached:0
Servo Index:10 Attached:0
Servo Index:11 Attached:0
Exit PWMServoNew::attach
Enter PWMServoNew::attachint pinArg: 9 min: 800 max: 2200
attach Before - Reg Contents
Timer:1
TCCR1A:Adrs: 80 Val:AA

TCCR1B:Adrs: 81 Val:1A

OCR1A:Adrs: 88 Val:BB8

OCR1B:Adrs: 8A Val:BB8

OCR1C:Adrs: 8C Val:0

TIMSK1:Adrs: 6F Val:0

ICR1:Adrs: 86 Val:9C40

Timer:3
TCCR3A:Adrs: 90 Val:AA

TCCR3B:Adrs: 91 Val:1A

OCR3A:Adrs: 98 Val:BB8

OCR3B:Adrs: 9A Val:BB8

OCR3C:Adrs: 9C Val:0

TIMSK3:Adrs: 71 Val:0

ICR3:Adrs: 96 Val:9C40

Timer:4
TCCR4A:Adrs: A0 Val:AA

TCCR4B:Adrs: A1 Val:1A

OCR4A:Adrs: A8 Val:BB8

OCR4B:Adrs: AA Val:BB8

OCR4C:Adrs: AC Val:0

TIMSK4:Adrs: 72 Val:0

ICR4:Adrs: A6 Val:9C40

Timer:5
TCCR5A:Adrs: 120 Val:1

TCCR5B:Adrs: 121 Val:3

OCR5A:Adrs: 128 Val:0

OCR5B:Adrs: 12A Val:0

OCR5C:Adrs: 12C Val:0

TIMSK5:Adrs: 73 Val:0

ICR5:Adrs: 126 Val:0

HdwrCntrlInfo:
sizeof volatile unit16_t * :2
servoPinIndex: 9
boardPinNumber: 46
tccrnA: 120
tccrnB: 121
ocrnA: 128
ocrnB: 12A
timskn: 73
icrn: 126
attachTccrnaClrMsk: 40
attachTccrnaSetMsk: 80
seizeTimerTimsknClrMsk: F
seizeTimerTimsknSetMsk: 0
detachTccrnaClrMsk: C0
detachTccrnaSetMsk: 0
writeOcrnx: 128
Enter PWMServoNew::seizeTimer
Reg Contents Before
Timer:1
TCCR1A:Adrs: 80 Val:AA

TCCR1B:Adrs: 81 Val:1A

OCR1A:Adrs: 88 Val:BB8

OCR1B:Adrs: 8A Val:BB8

OCR1C:Adrs: 8C Val:0

TIMSK1:Adrs: 6F Val:0

ICR1:Adrs: 86 Val:9C40

Timer:3
TCCR3A:Adrs: 90 Val:AA

TCCR3B:Adrs: 91 Val:1A

OCR3A:Adrs: 98 Val:BB8

OCR3B:Adrs: 9A Val:BB8

OCR3C:Adrs: 9C Val:0

TIMSK3:Adrs: 71 Val:0

ICR3:Adrs: 96 Val:9C40

Timer:4
TCCR4A:Adrs: A0 Val:AA

TCCR4B:Adrs: A1 Val:1A

OCR4A:Adrs: A8 Val:BB8

OCR4B:Adrs: AA Val:BB8

OCR4C:Adrs: AC Val:0

TIMSK4:Adrs: 72 Val:0

ICR4:Adrs: A6 Val:9C40

Timer:5
TCCR5A:Adrs: 120 Val:1

TCCR5B:Adrs: 121 Val:3

OCR5A:Adrs: 128 Val:0

OCR5B:Adrs: 12A Val:0

OCR5C:Adrs: 12C Val:0

TIMSK5:Adrs: 73 Val:0

ICR5:Adrs: 126 Val:0

Reg Contents After
Timer:1
TCCR1A:Adrs: 80 Val:AA

TCCR1B:Adrs: 81 Val:1A

OCR1A:Adrs: 88 Val:BB8

OCR1B:Adrs: 8A Val:BB8

OCR1C:Adrs: 8C Val:0

TIMSK1:Adrs: 6F Val:0

ICR1:Adrs: 86 Val:9C40

Timer:3
TCCR3A:Adrs: 90 Val:AA

TCCR3B:Adrs: 91 Val:1A

OCR3A:Adrs: 98 Val:BB8

OCR3B:Adrs: 9A Val:BB8

OCR3C:Adrs: 9C Val:0

TIMSK3:Adrs: 71 Val:0

ICR3:Adrs: 96 Val:9C40

Timer:4
TCCR4A:Adrs: A0 Val:AA

TCCR4B:Adrs: A1 Val:1A

OCR4A:Adrs: A8 Val:BB8

OCR4B:Adrs: AA Val:BB8

OCR4C:Adrs: AC Val:0

TIMSK4:Adrs: 72 Val:0

ICR4:Adrs: A6 Val:9C40

Timer:5
TCCR5A:Adrs: 120 Val:2

TCCR5B:Adrs: 121 Val:1A

OCR5A:Adrs: 128 Val:BB8

OCR5B:Adrs: 12A Val:BB8

OCR5C:Adrs: 12C Val:0

TIMSK5:Adrs: 73 Val:0

ICR5:Adrs: 126 Val:9C40

Exit PWMServoNew::seizeTimer
attach After - Reg Contents
Timer:1
TCCR1A:Adrs: 80 Val:AA

TCCR1B:Adrs: 81 Val:1A

OCR1A:Adrs: 88 Val:BB8

OCR1B:Adrs: 8A Val:BB8

OCR1C:Adrs: 8C Val:0

TIMSK1:Adrs: 6F Val:0

ICR1:Adrs: 86 Val:9C40

Timer:3
TCCR3A:Adrs: 90 Val:AA

TCCR3B:Adrs: 91 Val:1A

OCR3A:Adrs: 98 Val:BB8

OCR3B:Adrs: 9A Val:BB8

OCR3C:Adrs: 9C Val:0

TIMSK3:Adrs: 71 Val:0

ICR3:Adrs: 96 Val:9C40

Timer:4
TCCR4A:Adrs: A0 Val:AA

TCCR4B:Adrs: A1 Val:1A

OCR4A:Adrs: A8 Val:BB8

OCR4B:Adrs: AA Val:BB8

OCR4C:Adrs: AC Val:0

TIMSK4:Adrs: 72 Val:0

ICR4:Adrs: A6 Val:9C40

Timer:5
TCCR5A:Adrs: 120 Val:82

TCCR5B:Adrs: 121 Val:1A

OCR5A:Adrs: 128 Val:BB8

OCR5B:Adrs: 12A Val:BB8

OCR5C:Adrs: 12C Val:0

TIMSK5:Adrs: 73 Val:0

ICR5:Adrs: 126 Val:9C40

Servo Index:0 Attached:1
Servo Index:1 Attached:1
Servo Index:2 Attached:1
Servo Index:3 Attached:1
Servo Index:4 Attached:1
Servo Index:5 Attached:1
Servo Index:6 Attached:1
Servo Index:7 Attached:1
Servo Index:8 Attached:1
Servo Index:9 Attached:1
Servo Index:10 Attached:0
Servo Index:11 Attached:0
Exit PWMServoNew::attach
Enter PWMServoNew::attachint pinArg: 10 min: 800 max: 2200
attach Before - Reg Contents
Timer:1
TCCR1A:Adrs: 80 Val:AA

TCCR1B:Adrs: 81 Val:1A

OCR1A:Adrs: 88 Val:BB8

OCR1B:Adrs: 8A Val:BB8

OCR1C:Adrs: 8C Val:0

TIMSK1:Adrs: 6F Val:0

ICR1:Adrs: 86 Val:9C40

Timer:3
TCCR3A:Adrs: 90 Val:AA

TCCR3B:Adrs: 91 Val:1A

OCR3A:Adrs: 98 Val:BB8

OCR3B:Adrs: 9A Val:BB8

OCR3C:Adrs: 9C Val:0

TIMSK3:Adrs: 71 Val:0

ICR3:Adrs: 96 Val:9C40

Timer:4
TCCR4A:Adrs: A0 Val:AA

TCCR4B:Adrs: A1 Val:1A

OCR4A:Adrs: A8 Val:BB8

OCR4B:Adrs: AA Val:BB8

OCR4C:Adrs: AC Val:0

TIMSK4:Adrs: 72 Val:0

ICR4:Adrs: A6 Val:9C40

Timer:5
TCCR5A:Adrs: 120 Val:82

TCCR5B:Adrs: 121 Val:1A

OCR5A:Adrs: 128 Val:BB8

OCR5B:Adrs: 12A Val:BB8

OCR5C:Adrs: 12C Val:0

TIMSK5:Adrs: 73 Val:0

ICR5:Adrs: 126 Val:9C40

HdwrCntrlInfo:
sizeof volatile unit16_t * :2
servoPinIndex: 10
boardPinNumber: 45
tccrnA: 120
tccrnB: 121
ocrnA: 128
ocrnB: 12A
timskn: 73
icrn: 126
attachTccrnaClrMsk: 10
attachTccrnaSetMsk: 20
seizeTimerTimsknClrMsk: F
seizeTimerTimsknSetMsk: 0
detachTccrnaClrMsk: 30
detachTccrnaSetMsk: 0
writeOcrnx: 12A
attach After - Reg Contents
Timer:1
TCCR1A:Adrs: 80 Val:AA

TCCR1B:Adrs: 81 Val:1A

OCR1A:Adrs: 88 Val:BB8

OCR1B:Adrs: 8A Val:BB8

OCR1C:Adrs: 8C Val:0

TIMSK1:Adrs: 6F Val:0

ICR1:Adrs: 86 Val:9C40

Timer:3
TCCR3A:Adrs: 90 Val:AA

TCCR3B:Adrs: 91 Val:1A

OCR3A:Adrs: 98 Val:BB8

OCR3B:Adrs: 9A Val:BB8

OCR3C:Adrs: 9C Val:0

TIMSK3:Adrs: 71 Val:0

ICR3:Adrs: 96 Val:9C40

Timer:4
TCCR4A:Adrs: A0 Val:AA

TCCR4B:Adrs: A1 Val:1A

OCR4A:Adrs: A8 Val:BB8

OCR4B:Adrs: AA Val:BB8

OCR4C:Adrs: AC Val:0

TIMSK4:Adrs: 72 Val:0

ICR4:Adrs: A6 Val:9C40

Timer:5
TCCR5A:Adrs: 120 Val:A2

TCCR5B:Adrs: 121 Val:1A

OCR5A:Adrs: 128 Val:BB8

OCR5B:Adrs: 12A Val:BB8

OCR5C:Adrs: 12C Val:0

TIMSK5:Adrs: 73 Val:0

ICR5:Adrs: 126 Val:9C40

Servo Index:0 Attached:1
Servo Index:1 Attached:1
Servo Index:2 Attached:1
Servo Index:3 Attached:1
Servo Index:4 Attached:1
Servo Index:5 Attached:1
Servo Index:6 Attached:1
Servo Index:7 Attached:1
Servo Index:8 Attached:1
Servo Index:9 Attached:1
Servo Index:10 Attached:1
Servo Index:11 Attached:0
Exit PWMServoNew::attach
Enter PWMServoNew::attachint pinArg: 11 min: 800 max: 2200
attach Before - Reg Contents
Timer:1
TCCR1A:Adrs: 80 Val:AA

TCCR1B:Adrs: 81 Val:1A

OCR1A:Adrs: 88 Val:BB8

OCR1B:Adrs: 8A Val:BB8

OCR1C:Adrs: 8C Val:0

TIMSK1:Adrs: 6F Val:0

ICR1:Adrs: 86 Val:9C40

Timer:3
TCCR3A:Adrs: 90 Val:AA

TCCR3B:Adrs: 91 Val:1A

OCR3A:Adrs: 98 Val:BB8

OCR3B:Adrs: 9A Val:BB8

OCR3C:Adrs: 9C Val:0

TIMSK3:Adrs: 71 Val:0

ICR3:Adrs: 96 Val:9C40

Timer:4
TCCR4A:Adrs: A0 Val:AA

TCCR4B:Adrs: A1 Val:1A

OCR4A:Adrs: A8 Val:BB8

OCR4B:Adrs: AA Val:BB8

OCR4C:Adrs: AC Val:0

TIMSK4:Adrs: 72 Val:0

ICR4:Adrs: A6 Val:9C40

Timer:5
TCCR5A:Adrs: 120 Val:A2

TCCR5B:Adrs: 121 Val:1A

OCR5A:Adrs: 128 Val:BB8

OCR5B:Adrs: 12A Val:BB8

OCR5C:Adrs: 12C Val:0

TIMSK5:Adrs: 73 Val:0

ICR5:Adrs: 126 Val:9C40

HdwrCntrlInfo:
sizeof volatile unit16_t * :2
servoPinIndex: 11
boardPinNumber: 44
tccrnA: 120
tccrnB: 121
ocrnA: 128
ocrnB: 12A
timskn: 73
icrn: 126
attachTccrnaClrMsk: 4
attachTccrnaSetMsk: 8
seizeTimerTimsknClrMsk: F
seizeTimerTimsknSetMsk: 0
detachTccrnaClrMsk: C
detachTccrnaSetMsk: 0
writeOcrnx: 12C
attach After - Reg Contents
Timer:1
TCCR1A:Adrs: 80 Val:AA

TCCR1B:Adrs: 81 Val:1A

OCR1A:Adrs: 88 Val:BB8

OCR1B:Adrs: 8A Val:BB8

OCR1C:Adrs: 8C Val:0

TIMSK1:Adrs: 6F Val:0

ICR1:Adrs: 86 Val:9C40

Timer:3
TCCR3A:Adrs: 90 Val:AA

TCCR3B:Adrs: 91 Val:1A

OCR3A:Adrs: 98 Val:BB8

OCR3B:Adrs: 9A Val:BB8

OCR3C:Adrs: 9C Val:0

TIMSK3:Adrs: 71 Val:0

ICR3:Adrs: 96 Val:9C40

Timer:4
TCCR4A:Adrs: A0 Val:AA

TCCR4B:Adrs: A1 Val:1A

OCR4A:Adrs: A8 Val:BB8

OCR4B:Adrs: AA Val:BB8

OCR4C:Adrs: AC Val:0

TIMSK4:Adrs: 72 Val:0

ICR4:Adrs: A6 Val:9C40

Timer:5
TCCR5A:Adrs: 120 Val:AA

TCCR5B:Adrs: 121 Val:1A

OCR5A:Adrs: 128 Val:BB8

OCR5B:Adrs: 12A Val:BB8

OCR5C:Adrs: 12C Val:0

TIMSK5:Adrs: 73 Val:0

ICR5:Adrs: 126 Val:9C40

Servo Index:0 Attached:1
Servo Index:1 Attached:1
Servo Index:2 Attached:1
Servo Index:3 Attached:1
Servo Index:4 Attached:1
Servo Index:5 Attached:1
Servo Index:6 Attached:1
Servo Index:7 Attached:1
Servo Index:8 Attached:1
Servo Index:9 Attached:1
Servo Index:10 Attached:1
Servo Index:11 Attached:1
Exit PWMServoNew::attach
PWMServoNew::write wrote to Adrs: 88 Val:640

PWMServoNew::write wrote to Adrs: 88 Val:728

PWMServoNew::write wrote to Adrs: 88 Val:810

PWMServoNew::write wrote to Adrs: 88 Val:8F8

PWMServoNew::write wrote to Adrs: 88 Val:9E0

PWMServoNew::write wrote to Adrs: 88 Val:AC8

PWMServoNew::write wrote to Adrs: 88 Val:BB0

PWMServoNew::write wrote to Adrs: 88 Val:C98

PWMServoNew::write wrote to Adrs: 88 Val:D80

PWMServoNew::write wrote to Adrs: 88 Val:E68

PWMServoNew::write wrote to Adrs: 88 Val:F50

PWMServoNew::write wrote to Adrs: 88 Val:1038

PWMServoNew::write wrote to Adrs: 88 Val:1120

PWMServoNew::write wrote to Adrs: 8A Val:640

PWMServoNew::write wrote to Adrs: 8A Val:728

PWMServoNew::write wrote to Adrs: 8A Val:810

PWMServoNew::write wrote to Adrs: 8A Val:8F8

PWMServoNew::write wrote to Adrs: 8A Val:9E0

PWMServoNew::write wrote to Adrs: 8A Val:AC8

PWMServoNew::write wrote to Adrs: 8A Val:BB0

PWMServoNew::write wrote to Adrs: 8A Val:C98

PWMServoNew::write wrote to Adrs: 8A Val:D80

PWMServoNew::write wrote to Adrs: 8A Val:E68

PWMServoNew::write wrote to Adrs: 8A Val:F50

PWMServoNew::write wrote to Adrs: 8A Val:1038

PWMServoNew::write wrote to Adrs: 8A Val:1120

PWMServoNew::write wrote to Adrs: 8C Val:640

PWMServoNew::write wrote to Adrs: 8C Val:728

PWMServoNew::write wrote to Adrs: 8C Val:810

PWMServoNew::write wrote to Adrs: 8C Val:8F8

PWMServoNew::write wrote to Adrs: 8C Val:9E0

PWMServoNew::write wrote to Adrs: 8C Val:AC8

PWMServoNew::write wrote to Adrs: 8C Val:BB0

PWMServoNew::write wrote to Adrs: 8C Val:C98

PWMServoNew::write wrote to Adrs: 8C Val:D80

PWMServoNew::write wrote to Adrs: 8C Val:E68

PWMServoNew::write wrote to Adrs: 8C Val:F50

PWMServoNew::write wrote to Adrs: 8C Val:1038

PWMServoNew::write wrote to Adrs: 8C Val:1120

PWMServoNew::write wrote to Adrs: 98 Val:640

PWMServoNew::write wrote to Adrs: 98 Val:728

PWMServoNew::write wrote to Adrs: 98 Val:810

PWMServoNew::write wrote to Adrs: 98 Val:8F8

PWMServoNew::write wrote to Adrs: 98 Val:9E0

PWMServoNew::write wrote to Adrs: 98 Val:AC8

PWMServoNew::write wrote to Adrs: 98 Val:BB0

PWMServoNew::write wrote to Adrs: 98 Val:C98

PWMServoNew::write wrote to Adrs: 98 Val:D80

PWMServoNew::write wrote to Adrs: 98 Val:E68

PWMServoNew::write wrote to Adrs: 98 Val:F50

PWMServoNew::write wrote to Adrs: 98 Val:1038

PWMServoNew::write wrote to Adrs: 98 Val:1120

PWMServoNew::write wrote to Adrs: 9A Val:640

PWMServoNew::write wrote to Adrs: 9A Val:728

PWMServoNew::write wrote to Adrs: 9A Val:810

PWMServoNew::write wrote to Adrs: 9A Val:8F8

PWMServoNew::write wrote to Adrs: 9A Val:9E0

PWMServoNew::write wrote to Adrs: 9A Val:AC8

PWMServoNew::write wrote to Adrs: 9A Val:BB0

PWMServoNew::write wrote to Adrs: 9A Val:C98

PWMServoNew::write wrote to Adrs: 9A Val:D80

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

PWMServoNew::write wrote to Adrs: 8A Val:AC8

PWMServoNew::write wrote to Adrs: 8A Val:BB0

PWMServoNew::write wrote to Adrs: 8A Val:C98

PWMServoNew::write wrote to Adrs: 8A Val:D80

PWMServoNew::write wrote to Adrs: 8A Val:E68

PWMServoNew::write wrote to Adrs: 8A Val:F50

PWMServoNew::write wrote to Adrs: 8A Val:1038

PWMServoNew::write wrote to Adrs: 8A Val:1120

PWMServoNew::write wrote to Adrs: 8C Val:640

PWMServoNew::write wrote to Adrs: 8C Val:728

PWMServoNew::write wrote to Adrs: 8C Val:810

PWMServoNew::write wrote to Adrs: 8C Val:8F8

PWMServoNew::write wrote to Adrs: 8C Val:9E0

PWMServoNew::write wrote to Adrs: 8C Val:AC8

PWMServoNew::write wrote to Adrs: 8C Val:BB0

PWMServoNew::write wrote to Adrs: 8C Val:C98

PWMServoNew::write wrote to Adrs: 8C Val:D80

PWMServoNew::write wrote to Adrs: 8C Val:E68

PWMServoNew::write wrote to Adrs: 8C Val:F50

PWMServoNew::write wrote to Adrs: 8C Val:1038

PWMServoNew::write wrote to Adrs: 8C Val:1120

PWMServoNew::write wrote to Adrs: 98 Val:640

PWMServoNew::write wrote to Adrs: 98 Val:728

PWMServoNew::write wrote to Adrs: 98 Val:810

PWMServoNew::write wrote to Adrs: 98 Val:8F8

PWMServoNew::write wrote to Adrs: 98 Val:9E0

PWMServoNew::write wrote to Adrs: 98 Val:AC8

PWMServoNew::write wrote to Adrs: 98 Val:BB0

PWMServoNew::write wrote to Adrs: 98 Val:C98

PWMServoNew::write wrote to Adrs: 98 Val:D80

PWMServoNew::write wrote to Adrs: 98 Val:E68

PWMServoNew::write wrote to Adrs: 98 Val:F50

PWMServoNew::write wrote to Adrs: 98 Val:1038

PWMServoNew::write wrote to Adrs: 98 Val:1120

PWMServoNew::write wrote to Adrs: 9A Val:640

PWMServoNew::write wrote to Adrs: 9A Val:728

PWMServoNew::write wrote to Adrs: 9A Val:810

PWMServoNew::write wrote to Adrs: 9A Val:8F8

PWMServoNew::write wrote to Adrs: 9A Val:9E0
