ghgemmer/Halloween/NewAndModedLibraries/PWMServoNew/PWMServoNew.h

#ifndef PWMServoNew_h
#define PWMServoNew_h

/*
  PWMServoNew.h - Hardware Servo Timer Library
  http://arduiniana.org/libraries/pwmservo/
  Author: Jim Studt, jim@federated.com
  Copyright (c) 2007 David A. Mellis.  All right reserved.
  renamed to PWMServo by Mikal Hart
  ported to other chips by Paul Stoffregen
  Updated to handle all PWM pins for Mega, and changed to generalize methods - G. Gemmer

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
  You should have received a copy of the GNU Lesser General Public
  License along with this library; if not, write to the Free Software
  Foundation, Inc., 51 Franklin St, Fifth Floor, Boston, MA  02110-1301  USA
*/
//#define PWM_SERVO_DEBUG 0
#include <inttypes.h>
#include <utility/avrTimerCounter.h>

//ATMega 168/328			Timer 1   Channels A,B
//ATMega 1280/2560		Timer 1,3,4,5   Channels A,B,C
//ATMega 644/644P			Timer 1 Channels A,B
//AT90USB162					Timer 1 channels A,B,C
//ATMega32U4					Timer 1 channels A,B,C, this also has a Timer 3 with channels A,B,C but only channel A gets outside on a teensy 2.0
//AT90USB646/1286			Timer 1,3 channels A,B,C

#if defined(__AVR_ATmega168__) || defined(__AVR_ATmega328P__) // Arduino
  #define SERVO_CPU_BOARD_TYPE1 0 
  #define SERVO_PIN_A 9  // Pin 9   PB1(OC1A/PCINT1)
  #define SERVO_PIN_B 10 // Pin 10  PB2(SS/OC1B/PCINT2)
  #define SERVO_MAX_NUM_PINS 2
#elif defined(__AVR_ATmega1280__) || defined(__AVR_ATmega2560__) // Arduino Mega
  #define SERVO_CPU_BOARD_TYPE2 0 
  #define SERVO_PIN_A 11// Pin 11 // (OC1A/PCINT5)PB5
  #define SERVO_PIN_B 12// Pin 12 // (OC1B/PCINT6)PB6
  #define SERVO_PIN_C 13// Pin 13 // (OC0A/OC1C/PCINT7)PB7
	#define SERVO_PIN_D 5 // Pin 5 // PE3(OC3A/AIN1)
	#define SERVO_PIN_E 2 // Pin 2 // PE4(OC3B/INT4)
	#define SERVO_PIN_F 3 // Pin 3 // PE5(OC3C/INT5)
	#define SERVO_PIN_G 6 // Pin 6 // PH3(OC4A)
	#define SERVO_PIN_H 7 // Pin 7 // PH4(OC4B)
	#define SERVO_PIN_I 8 // Pin 8 // PH5(OC4C)
  #define SERVO_PIN_J 46// Pin 46 // PL3(OC5A)
  #define SERVO_PIN_K 45// Pin 45 // PL4(OC5B)
  #define SERVO_PIN_L 44// Pin 44 // PL5(OC5C)
  #define SERVO_MAX_NUM_PINS 12
#elif defined(__AVR_ATmega644P__) || defined(__AVR_ATmega644__) // Sanguino
  #define SERVO_CPU_BOARD_TYPE3 0 
  #define SERVO_PIN_A 13 // Pin 13
  #define SERVO_PIN_B 12 // Pin 12
  #define SERVO_MAX_NUM_PINS 2 
#elif defined(__AVR_AT90USB162__) // Teensy 1.0
  #define SERVO_CPU_BOARD_TYPE4 0 
  #define SERVO_PIN_A 17 // Pin 17
  #define SERVO_PIN_B 18 // Pin 18
  #define SERVO_PIN_C 15 // Pin 15
  #define SERVO_MAX_NUM_PINS 3 
#elif defined(__AVR_ATmega32U4__) // Teensy 2.0
  #define SERVO_CPU_BOARD_TYPE5 0 
  #define SERVO_PIN_A 14 // Pin 14
  #define SERVO_PIN_B 15 // Pin 15
  #define SERVO_PIN_C 4  // Pin 4
  #define SERVO_MAX_NUM_PINS 3 
#elif defined(__AVR_AT90USB646__) || defined(__AVR_AT90USB1286__) // Teensy++
  #define SERVO_CPU_BOARD_TYPE6 0 
  #define SERVO_PIN_A 25 // Pin 25
  #define SERVO_PIN_B 26 // Pin 26
  #define SERVO_PIN_C 27 // Pin 27
  #define SERVO_MAX_NUM_PINS 3 
#else
  #define SERVO_CPU_BOARD_TYPE7 0 
  #define SERVO_PIN_A 9  // Pin 9
  #define SERVO_PIN_B 10 // Pin 10
  #define SERVO_MAX_NUM_PINS 2 
#endif

class PWMServoNew
{
  private:
  	
  	struct servoHdwrCntrlInfoDef 
  	{
  		// Used to define which 16 bit PWM timer counter and channel is used to control a given servo pin
  		// This captures this information in a table instead of inline logic for 16 bit counters to generalize the operations
  		int8_t servoPinIndex;  // Used to verify array index entry matches SERVO_PIN_<n> used as index.  Verifies constant tables
  		// constructed correctly
  		uint8_t boardPinNumber; //actual pin number on board
  		avrTimerCounter::timerCounterIdsDef timerId;
  	  avrTimerCounter::channelDef outputChannel;
  	};

  	struct servoInfoDef 
  	{
  		servoInfoDef() : attached(false){}
  		bool attached;
  	};
  	
    uint8_t pin;  //actual servo pin number
    int8_t  servoPinIndex; // index of the attached servo.  Used for servoInfo, and servoHdwrCntrlInfo
    											 //-1 means no servo attached for this object.  
    											 // Only one servo can be attached per PWMServoNew object.
    											 
    uint16_t angle;       // in degrees
    uint16_t  minPulseWidth;       // minimum servo pulse width, uS units
    uint16_t  maxPulseWidth;       // maximum servo pulse width, uS units
    int _minAngleDeg;   // angle corresponding to  minPulseWidth
    int _maxAngleDeg;   // angle corersonding to  maxPulseWidth
    const static servoHdwrCntrlInfoDef servoHdwrCntrlInfo[SERVO_MAX_NUM_PINS];
    static servoInfoDef servoInfo[SERVO_MAX_NUM_PINS];
    avrTimerCounter * timerPtr; // timer object associated with this servo pin
    servoHdwrCntrlInfoDef HdwrCntrlInfo; // copy for fast access
        
    void seizeTimer();
    void releaseTimer();
    int8_t  getServoPinIndex(uint8_t pin);
#ifdef PWM_SERVO_DEBUG
		void printServosAttached();
		void printAdrsValueHex(unsigned long address, unsigned long value);
		void printHdwrCntrlInfo(servoHdwrCntrlInfoDef &info);
#endif 

  public:
    PWMServoNew();
    uint8_t attach(int pinArg);
                             // pulse length for 0 degrees in microseconds, 544uS default
                             // pulse length for 180 degrees in microseconds, 2400uS default
    uint8_t attach(int pinArg, int min, int max, int minAngleDeg = 0, int maxAngleDeg = 180);
    // pinArg - pin number to connect servo to
    // min - min pulse width in microseconds corresponding minAngleDeg
    // max - max pulse width in microseconds corresponding maxAngleDeg
    // minAngleDeg - min angle the servo is allowed to be set to and corresponds to min pulse width.
    //               Note user can set this and min, max to limit travel of the servo less than it can actually do.
    // maxAngleDeg - max angle the servo is allowed to be set to and corresponds to max pulse width
    //               Note user can set this and min, max to limit travel of the servo less than it can actually do.
    void detach();
    void write(int angleArg, bool force = true); //
    // angleArg - Angle in degrees to set the servo to
    // force - force the write to the servo control hardware regardless of whether it has changed or not.
    uint8_t read();
    uint8_t attached();
    void getMinMaxDeg(int &min, int &max); // returns the min and max degree setting allowed.
};

#endif
