ghgemmer/Halloween/PWMServo/SavedImplementations/Impl1/examples/Sweep/Sweep.ino

// Sweep
// by BARRAGAN <http://barraganstudio.com> 

// http://arduiniana.org/libraries/pwmservo/

//   Board                     SERVO_PIN_A   SERVO_PIN_B   SERVO_PIN_C
//   -----                     -----------   -----------   -----------
//   Arduino Uno, Duemilanove       9            10          (none)
//   Arduino Mega                  11            12            13
//   Sanguino                      13            12          (none)
//   Teensy 1.0                    17            18            15
//   Teensy 2.0                    14            15             4
//   Teensy++ 1.0 or 2.0           25            26            27

#include <PWMServo.h> 
 
PWMServo myservo;  // create servo object to control a servo 
                // a maximum of eight servo objects can be created 
 
int pos = 0;    // variable to store the servo position 
 
void setup() 
{ 
  myservo.attach(11,800,2200);  // attaches the servo on pin 11 to the servo object 
} 
 
 
void loop() 
{ 
  for(pos = 75; pos < 126; pos += 1)  // goes over range in degrees 
  {                                  // in steps of 1 degree 
    myservo.write(pos);              // tell servo to go to position in variable 'pos' 
    delay(10);                       // waits 15ms for the servo to reach the position 
  } 
  delay(10000);
  for(pos = 125; pos>=74; pos-=1)     // oes over range in degrees
  {                                
    myservo.write(pos);              // tell servo to go to position in variable 'pos' 
    delay(10);                       // waits 15ms for the servo to reach the position 
  } 
  delay(10000);
} 
