ghgemmer/Halloween/(commit log)

2020-10-02 Update Sandbox.ino
    Added Set and Get Stored Calibration Data commands. This allows IMU calibration data to be stored in eeprom as well as being restored from eeprom to the IMU. Minor spelling corrections
2020-10-03 Update Lessons Learned.docx
    Updated Lessons learned to indicate the up/down side of the IMU is important when placing the IMU on a surface otherwise readings of the IMU can jump and be off when the surface is moved (i.e pitch , yaw, roll of the surface is changed) beyond certain ranges.
2020-10-03 Update Lessons Learned.docx
    Added - microphone device that was added for interactive sessons
    - Need for I2C switch hub if using more than 2 IMUs
    - Minor reorganization and spelling corrections
2020-10-06 Update Sandbox.ino
    Changed Mouth open scaling to be more pronounced as it looks better on the prop.
2020-10-09 Wiring Diagram Updates
    Updated Prop Wiring to add Mouth servo, BNo055 sensors. Added connections from Arduino, added Electrec microphone device.. Added actual pictures of Wiring, etc
2020-10-12 Future arm movement updates
    Updated future arm movements on what sections of arm servos needed for.
2020-11-01 Added more leasons and suggested enhancements
    Added more lessons learned. Also added quick commands for interactive prop movements and calibration.
2020-11-02 Added further future enhancements
    Added LED eye brightness future enhancement and changed arm enhancement to use 3 servos on upper arm so get yaw, pitch, and roll for arm
2020-11-02 Note to add blocking cap to receive audio
    Add blocking capacitor to receive audio from prop before it goest to headphones
2020-11-02 Addeed receive audio blocking cap
    Addeed receive audio blocking capacitor between receive audio from prop and headset speakers. This allowed volume control to be turned up higher than before.
2020-11-02 Create VU meter a led, KA2284.pdf
2020-12-23 Various Servo Driver Implementations and test logs
    Added Several different Servo Driver Implementations and captured test logs for those implementations.
2020-12-23 Added ground issues and possible fixes and possible use of Servo shield
2021-01-18 Uses larger increments for testing gobilda servos
2021-02-10 Updated Audio Mic and LED wiring
    Updated Audio Mic (both TX and Rcv) and LED wiring
2021-02-13 Updates for moving to IDE 1.8.13
    Updates for moving to IDE 1.8.13. Compiler now requires forward prototype.
2021-02-13 Adding Linker Map generation statements
    Copy of Platform.txt wiith linker map generation statements. Note that the arduino avr-readelf utilityand avr-nm utiliyt can read the elf file the compiler produces to look at the symbol table, et.
2021-02-13 Create platform with Map generation statement.txt
    Copy of Platform.txt wiith linker map generation statements. Note that the arduino avr-readelf utilityand avr-nm utiliyt can read the elf file the compiler produces to look at the symbol table, et
2021-02-15 Corrected potential PROGMEM const variables access issue
    Most PROGMEM const variables needs to be in lower 64K of flash as accessing most of them assumes this. So added a PROGMEMSECTION2 to move those that are always accessed as far addresses (can be anywhere in the address space) into that new region to avoid having PROGMEM const variables overflow beyond lower 64K regsion So moved the Dayo, and WereWolves of London setups into PROGMEMSECTION2 areas are assumed to be anywhere in flash memory and accessed via far routines.
    [program_memory_misc.h]
2021-02-15 Moved print const strings to PROGMEM to gain back RAM space
    Used F macro to move const strings into PROGMEM to gain back RAM space
2021-02-16 Gained back more RAM space putting last prop values in PROGMEMSECTION2 memory area
2021-02-16 Updated to show LED flexible cable now installed and working
2021-02-27 Corrections for new IDE and libraries plus removed some comments in one TestServos
    [PWMServoNew.h, TestServos.ino]
2021-08-28 Mods for use of I2C switch for multiple BNO055 sensors with same I2C address
    Mods for use of I2C switch for multiple BNO055 sensors with same I2C address.
    Added i2cSwitch class library, modified Adafruit_BNO055 class library to make read/writes virtual for overriding. added Adafruit_BNO055_HalloweenProp class to handle setting i2cSwtich appropriately during I2C read/write operations (overriding base class ops). Updated PropController.ino to use the new i2cSwtich class and Adafruit_BNO055_HalloweenProp class
    [I2C timing calculations.xlsx, serialconfig.txt]
2021-08-28 Added Arm Servo info comments and torque calculations
    Added Arm Servo info comments and torque calculations
    [ArmServoAngularAccelCalcs.xlsx]
2021-08-31 Added min max degrees to PWMServoNew.attach. TestServos now uses Serial Cmds
    Added min max degrees as optional parameters to PWMServoNew.attach so that can limit degree range. min max degrees corresponds to min, max pulse width params when specified, otherwise the min,max degrees id defaulted to 0, 180 respectively. Updated TestServos so that can control each servo through a SetServo serial cmd now to make testing easier.
2021-08-31 Correction to description of PWMServoNew Impl4
2021-09-07 Updated write to add force parameter
    if passed angle is not different than current angle and force is false (default is true) we don't write the timer hardware to eliminate any potential hardware issues (no issues known at this time but just good to do this in general)
    [PWMServoNew.cpp, PWMServoNew.h, TestServos.ino]
2021-10-01 Corrected servo angle limit
    PWMServoNew angle member variable was uint8_t and thus limited angle to 0 - 256 . Needed angle to go to at least 300 so changed it to uint16_t. Also replaced min/max16 which are 16usec units with minPulseWidth/maxPulseWidth in usec and removed the * 16L in write to reduce confusion (i.e. why divide by 16 and then turn around and multiply by 16 in write if that is the only place min/max16 are used)
    [PWMServoNew.cpp, PWMServoNew.h, TestServos.ino]
2021-10-16 Added Arm servo info and limits
    Added Arm servo info to prop wiring and modified/added servo limits and defaults to arm servo angular calculations and test servo commands Made terminal labels file containing printable labels to add to terminal block.
    [ArmServoAngularAccelCalcs.xlsx, OtherArmTorqueCalcs.xlsx]
2021-10-19 Added Arm IMUs, upped Cmd size
    Added Arm IMU instantiations. Upped Cmd buffer size
2021-10-19 Deleted Madgwick, LSM9DS1 IMU code
    Since don't use these anymore as use the BNO055 IMUs, am removing the code to make it less cluttered (plus its version is still accessible in git if needed).
    Also updated the number of sensors can store calibration data for in eeprom to accomodate the 2 new arm IMU sensors ad
2021-10-19 Updated program_memory_misc name to avoid conflicts later on
    Updated program_memory_misc.h name and class to avoid conflicts later on when use with propcontroller. Also removed the pgm_get_far_address as it is present already in the included library files.
    [PWMServoNew.cpp, avrTimerCounter.cpp, program_memory_misc.h, program_memory_misc_items.cpp, program_memory_misc_items.h]
2021-10-20 Added PWMServoNew library
    This is PWMServoNewSavedImplementations\Impl4. Corrected avrTimerCounter.cpp to include avrTimerCounter.h instead of PWMServoNew.h. This library compiles fine and works.
    [PWMServoNew.cpp, PWMServoNew.h, TestServos.ino, avrTimerCounter.cpp, avrTimerCounter.h, program_memory_misc_items.cpp, program_memory_misc_items.h]
2021-10-20 Updated the NO_ANGLE value indicating first angle write after attach.
    Updated the NO_ANGLE value indicating first angle write after attach.. Used value larger than largest angle a user would write.
2021-10-20 Added Arm Servos and Positions set cmds for them as well as using new PWMServoNew library now
    Added Arm Servos and Positions set cmds for them along with constants defining angle limits for the servos. Switched to using PWMServoNew library instead of PWMServo to allow accessing up to 12 servos (of which 7 are now used)
2021-10-23 Refactoring by adding servoFilter class to replace inline code
    Refactoring by adding servoFilter class to replace inline PropController.ino. Inline code would ignore new servo inputs when the servo was still transitioning to the last input. Also updated servo Mouth scaling to be more sensitive.
    [servo_filter.cpp, servo_filter.h]
2021-10-23 Remove files no longer needed
    [PropDevicesValues - Copy.xls]
2021-10-27 Moded ImuHeadMouth cmd to add live synchronized Arm, Elbow movements.
    Moded ImuHeadMouth cmd to add Live Arm, Elbow movements. Tested using arm IMUs hinge block by moving it by hand (not strapped to arm yet, but will try that next). Pretty cool and mostly works with a few issues 1) When arm IMU roll gets over 40 degrees or so the prop elbow which was bent at 90 degrees on the IMU hinge block appears to straighten as the roll increases for some reason even though I am not straightening the elbow on the IMU hinge block. 2) Sometimes the prop arm will briefly stop and then jump to the final position when moving arm IMU block swiftly. Not sure if IMU position read is causing this by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
    [imu_filter.cpp, imu_filter.h]
2021-10-29 Added DelayMsec cmd, and discrete pin to make it easier to run and stop head mouth ops
    Added DelayMsec cmd to make it easier to get in default position before head mouth ops cmd is executed. Likewise added a discrete pin that stops head mouth ops as can't really use right arm to do this as prop follows arm, so can use left arm to click button (or eventually foot if needed). Currently still have issues with attaching sensors directly to my arms as when muscles contract they bulge and can move sensors. Looking at ways to avoid eliminate this like attaching sensor on side or under side of arm some how. Use of a dummy arm with sensors attached and manually moved by me seems to work pretty d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
2021-10-29 Added delay cmd before IMU head mouth ops start
2021-10-30 Updated user talk mic amp description to indicate agc turned via hardware
    Updated user talk mic amp description to indicate agc turned via hardware by connecting 9814 TH to MICBIAS, also added 10K ohm resistor in series to 9814 output to reduce output to speaker to eliminate feedback pick up from outdoor speaker and people speaking feeding back to indoor mic.
2021-10-31 Added first stab at Vampire Grasping/Lunging at player
    Added first stab at Vampire Grasping/Lunging at trick or treater's player. Need to add in head and mouth movement and LED eyes. Hissing appears to be at correct time, just need to add in head and mouth
    [VampireArmCapture.xlsx]
2021-10-31 Completed Vampire Arm Capture sequence
    Adjusted head mouth timing. Added Eye LED control. Modified quick commands including setting ready for power off head vertical position to 140 as now have donut on neck to ease mouth hitting neck when power removed.
    [VampireArmCapture.xlsx]
2021-11-06 Corrected header to remove accidental substitution
    [PWMServoNew.h]
2021-11-07 Updated Lessons Learned and documentation before github repo made public
    [ArmServoAngularAccelCalcs.xlsx]
2021-11-08 cut and paste corrections to AudioBloodCurdlngScream command
2021-11-08 Updated ImuHeadMouth cmd description to indicate it outputs servo positions on the serial monitor
2021-11-08 Added file numbers for audio file selection in ImuHeadMouth cmd
2021-11-08 More updates and a prop picture inline
2021-11-09 Documentation updates
    Added descriptions for classes and newly developed libraries to the README.md file. Updated Prop Wiring to replace air cylinder relay with the wording air cylinder solenoid valve.
2021-11-10 Added links to photos in appropriate spots, added more detail
    In Readme.md added links to photos in appropriate spots, added more detail. Update Prop Wiring to indicate the solenoid valve that was actually used.
2021-11-10 Corrected what IMU is an abbreviation for
2021-11-10 Added more pictures and wording about prop body
2021-11-11 More updates related to servo placement, servo wiring placement, and eliminating noise on mic
2021-11-11 Switching pic refs to github
2021-11-12 changed all references for pics to the local PropPics dir jpgs., added camera Homeye app tool
2021-11-12 Minor detail updates about prop legs and shoulder blades
2021-11-13 Numerous updates
    Additions about pneumatic finickyness,, availability of PVC hub clamps, added prop platform stabilizer photo, grammar corrections, made dirs and files in Directories and Files section links
2021-11-13 Further detail and grammar corrections
    More detail on what was used to slow the speed of air cylinder. Grammar corrections and rewording.
2021-11-13 Added more detail about speed control for the cylinder and air routing.
2021-11-13 Further correction on the pneumatics operation
2021-11-13 Mouth guard is technically a bike/football chin cup strap
2021-11-14 Added further notes on wiring routing for servos
2021-11-14 Added detail on choosing a servo power supply
2021-11-19 Added info about possible use of servo gearboxes or larger servos.
2022-10-29 Updated to use gobilda servo for head Nod now, use of New op
    Updated to use gobilda servo for head Nod now instead of Hitec so that no longer have servo whine. Also seems servo is as fast as the Hitec one so can run at 6V instead of 7.4 althouigh that is still an options if want faster operatoni.
    Added - use of New op with free to show can use New now. Only use it for the LED device at the moment.
    Also added in call to print freeMemory after New of LED device to see how much space use of New took up.
    [ArmServoAngularAccelCalcs.xlsx]
2023-10-14 Grammatical corrections and indicated GoBilda Servo used for head nod now
    Grammatical corrections and indicated GoBilda Servo used for head nod now
2023-10-14 Updated for Gobilda now used for head nod servo
    Updated for Gobilda now used for head nod servo
2023-10-29 Updates for getting mimicing movement with arm brace mostly working
    Code Updates for getting prop synchronized movement to arm brace IMUs mostly working. There are still weird transitions that sometimes occur where the prop arm goes to some wild position momentarily or statically when the elbow / arm imu pitch is more than 133 degrees (so limit IMU usage to no more than that but maybe don't even update Yaw in that case in the IMU filter?).. So it's mostly an IMU issue with certain positions. like also 90 degrees pitch, can also cause weird Yaw values too with certain motions. Tried using quaternions and then converted back to Euler angles for final use with servo but it didn't make a d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
2024-08-22 Mods for reordering arm servos
    Changed hardware order of servos on arm to match normal Euler angle order and what the IMU sensors assume for yaw, pitch, roll. So now the pitch servo is connected to yaw shaft , and roll servo is connected to pitch shaft whereas before the order was roll servo connected to yaw shaft and pitch servo connected to roll shaft. The order is important as a given yaw, pitch, roll value does not yield the same arm orientation with a different servo order (i.e. which shaft the yaw, pitch, roll servos are attached to). Once did this the prop arm now seems to reasonably follow/mimic the user arm movements, although more improvements with the arm brace and sensor pl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
2024-08-24 Updated prop pics of shoulder blade and arms and descriptions
    Updated prop pics of shoulder blade and arms and descriptions
2024-10-21 Updates for new audio commands and general readme updates
    PropController.ino updated to add 2 new audio commands AudioScreamingGhostChilldren and AudioISeeYou
    QuickHeadMouthCaptureCommands.txt updated a few starting out servo positions
    Readme.md - Various wording updates to clarify things, new audio commands, pointing to new videos,
    Lessons Learned - Added use of Mixer to mix pc audio, prop mp3 audio, and mic audio. Added sentence on scope showing 120V Ac on line when not actually there., as well as possibly ground loop problems. Added info on ISPY settings to capture IP cam audio as well. Updated wording on servo ordering and best arm brace position to use for mimicking moveme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
2024-10-21 New pics of wiring and updates in readme for them.
    New pics of wiring that include the accessible SD card interface
2024-10-22 Added SD card info in readme and connections in Prop Wiring
2024-10-22 Updated user mic and mp3output left/right channel detail
    Indicated that mic and mp3 outputs mix left channels, and right channels thru resistors to go to the left channel and right channel of the prop speaker
2024-10-26 Added the I See You prop player sequence
    [I See You Capture.xlsx]
2025-10-28 minor updates
    Servo shaft screw type, possible use of counter width to reduce torque requirements.
