ghgemmer/Halloween/(notices)

Notices in the files:
PropController/devices_player.h:
Copyright (c) 2021 Greg Gemmer.
MIT license
