ghgemmer/Halloween/PropPics/20240820_203353-YawthenPitchthenRoll.jpg

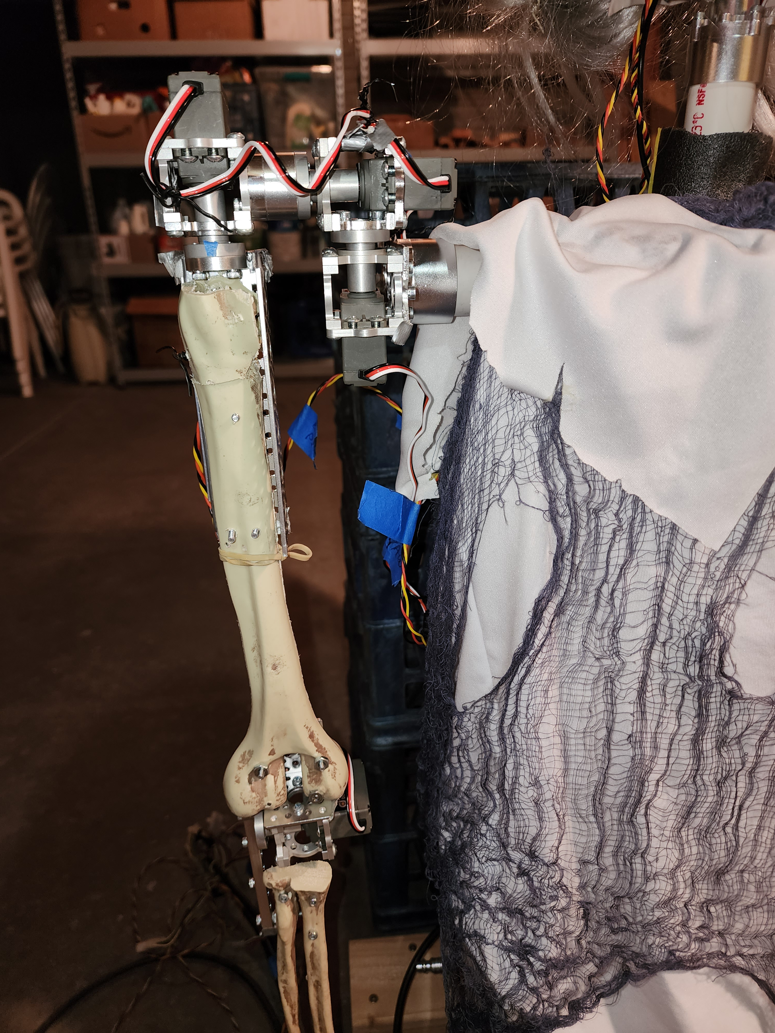
PropPics/20240820_203353-YawthenPitchthenRoll.jpg
