ghgemmer/Halloween/PropPics/20241019_185904.jpg

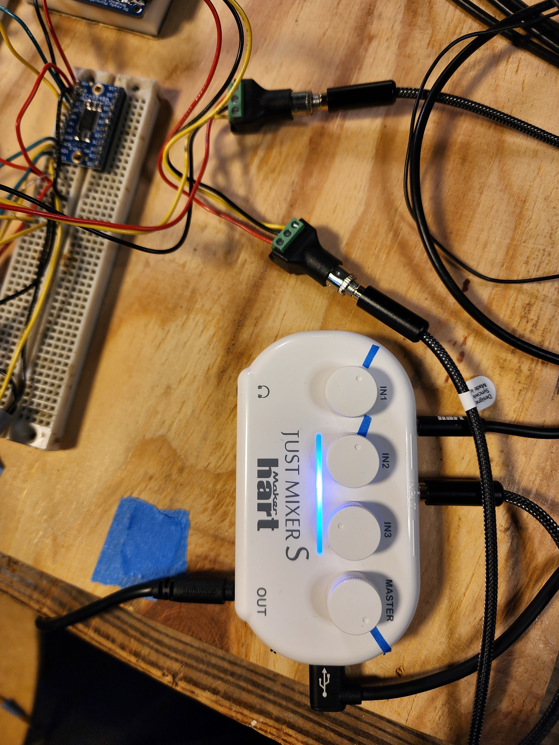
PropPics/20241019_185904.jpg
