ghgemmer/Halloween/PropPics/20211110_145718.jpg

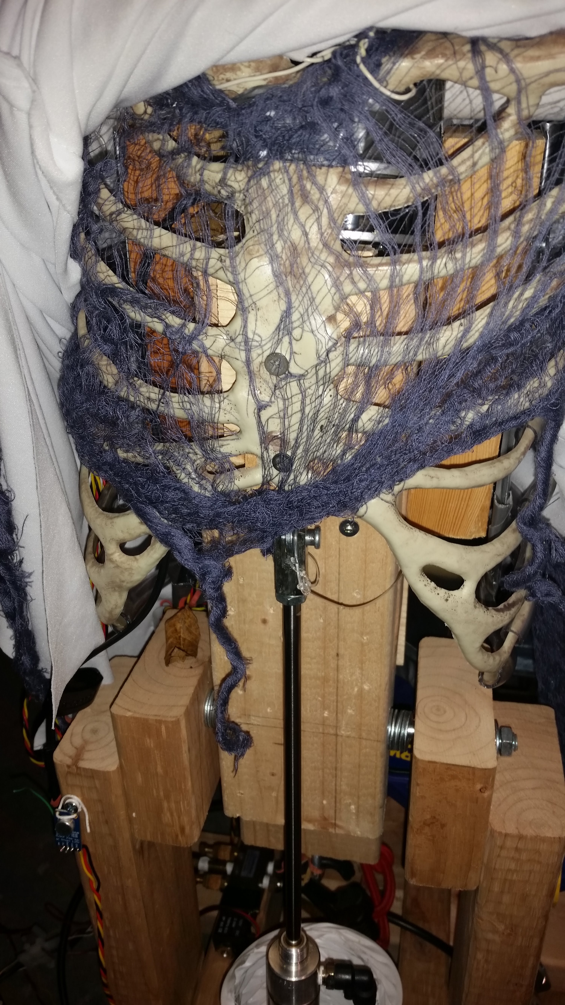
[picture p10: PropPics/20211110_145718.jpg]
PropPics/20211110_145718.jpg
