ghgemmer/Halloween/PropPics/20240823_193205.jpg

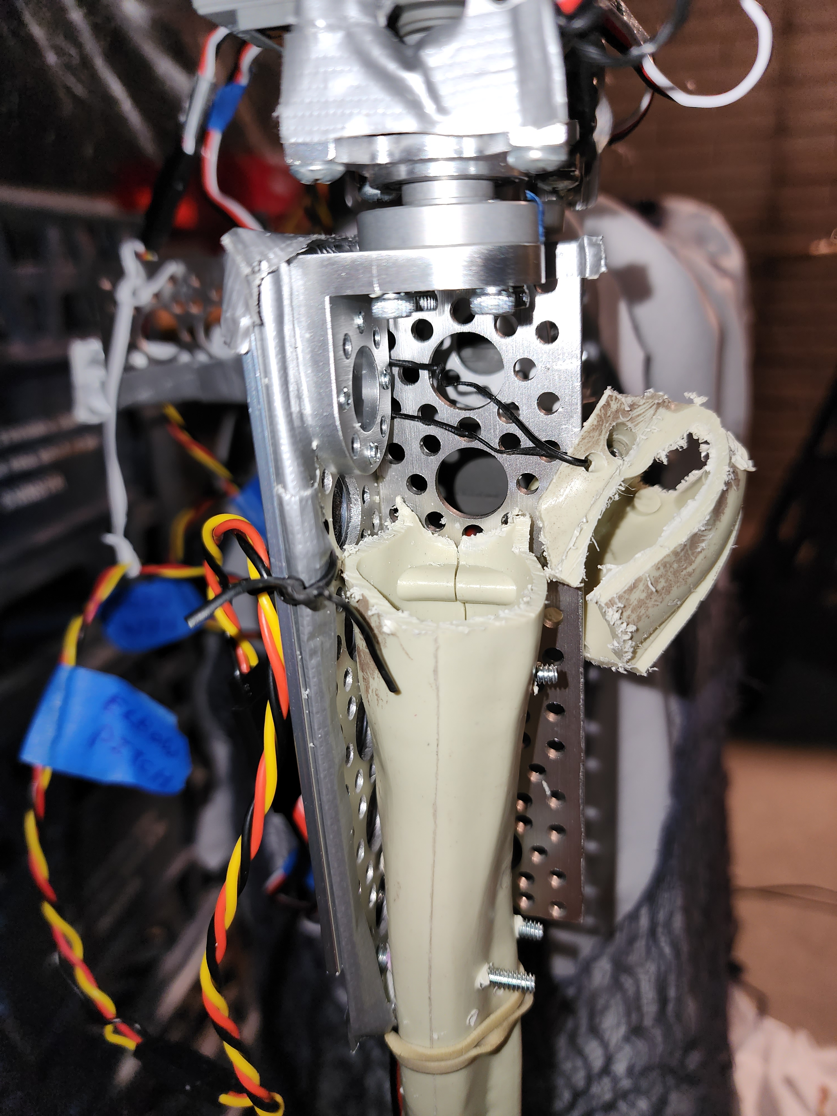
[picture p20: PropPics/20240823_193205.jpg]
PropPics/20240823_193205.jpg
